saitokiku/whirlydawg/4_DRAWINGS/README.md

# Step 4 – drawings and pictures

| File | What it shows |
|---|---|
| `fabrication_drawings.pdf` | **main drawing set** (12 sheets): sizes of every part, cut-away view, which parts spin and which are fixed, assembly order, calculations |
| `assembly_exploded.pdf` | pulled-apart view and the order the parts go together |
| `assembly_section.pdf` | cut-in-half view showing how the blades lock into the caps |
| `rotor_vs_stationary.pdf` | orange = spins, blue = fixed to the roof |
| `CAD_views_top_side_underside.pdf` | top, side and bottom views |
| `comparison_16_20_24_blades.pdf` | why 20 blades: 16 leaves gaps, 24 chokes the airflow |
| `images/` | all pictures (PNG) |

All pictures and drawings are generated from the real 3D model, not drawn by hand.
