saitokiku/whirlydawg/2_BLADES_cut_and_bend/blade_and_roof_templates_1to1.pdf

## BLADE CUTTING TEMPLATE - 1:1 - PRINT AT 100 % / ACTUAL SIZE (NO FIT-TO-PAGE)

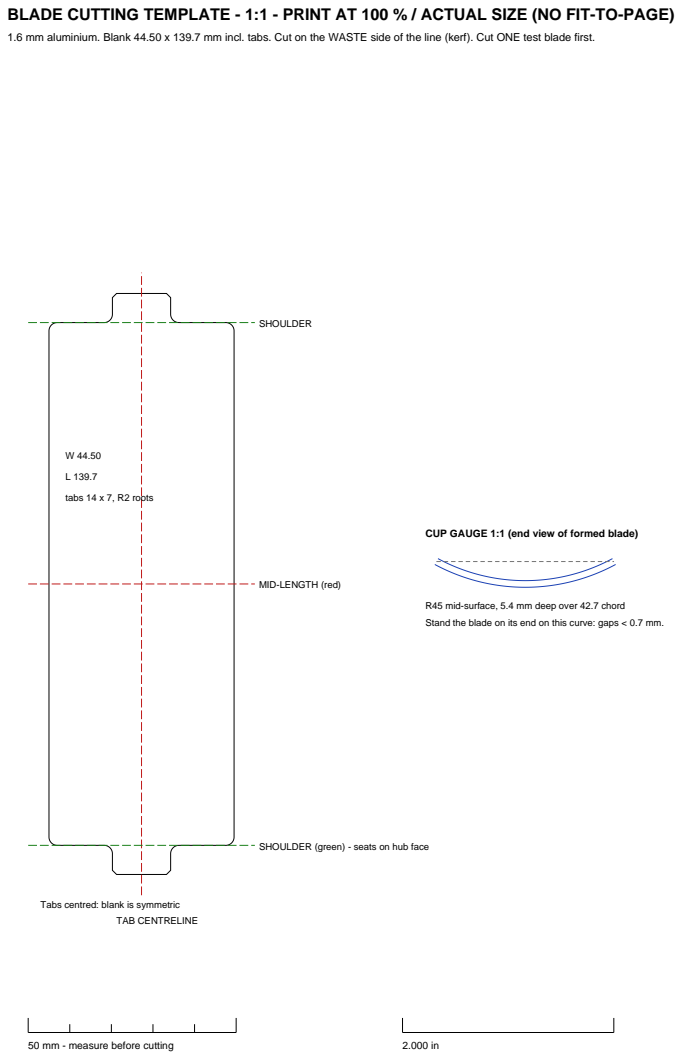
[picture p2: page 1]
SHOULDER; TAB CENTRELINE; tabs 14 x 7, R2 roots; 50 mm - measure before cutting

1.6 mm aluminium. Blank 44.50 x 139.7 mm incl. tabs. Cut on the WASTE side of the line (kerf). Cut ONE test blade first.

CUP GAUGE 1:1 (end view of formed blade)

MID-LENGTH (red)

R45 mid-surface, 5.4 mm deep over 42.7 chord
Stand the blade on its end on this curve: gaps < 0.7 mm.

SHOULDER (green) - seats on hub face

Tabs centred: blank is symmetric

## NESTED STOCK LAYOUT - 20 BLADES FROM 5 PIECES OF 11.75 x 3.75 in STOCK (SCALE 1:3)

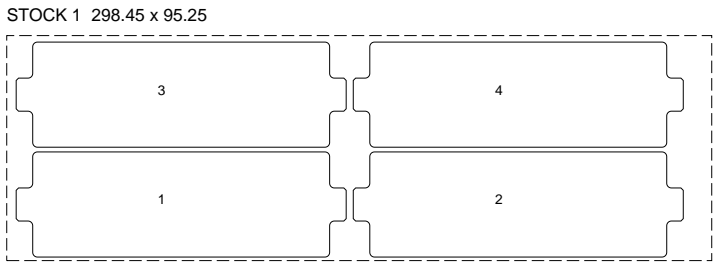
[picture p3: figure]
STOCK 1 298.45 x 95.25
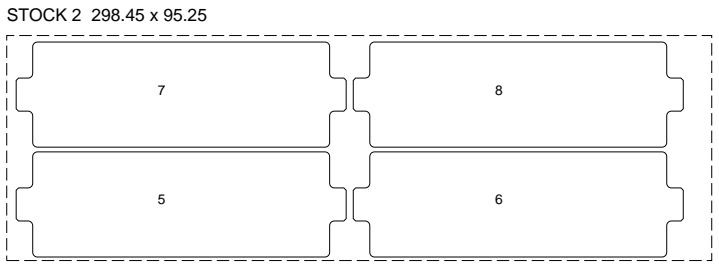
[picture p4: figure]
STOCK 2 298.45 x 95.25
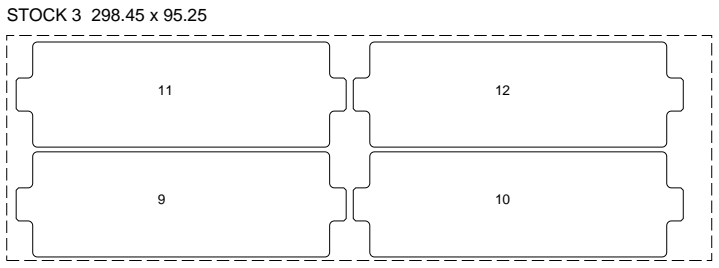
[picture p5: figure]
STOCK 3 298.45 x 95.25
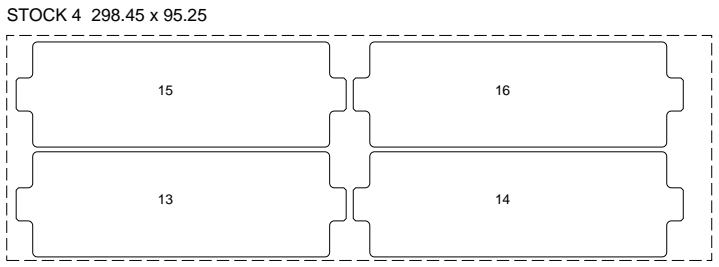
[picture p6: figure]
STOCK 4 298.45 x 95.25
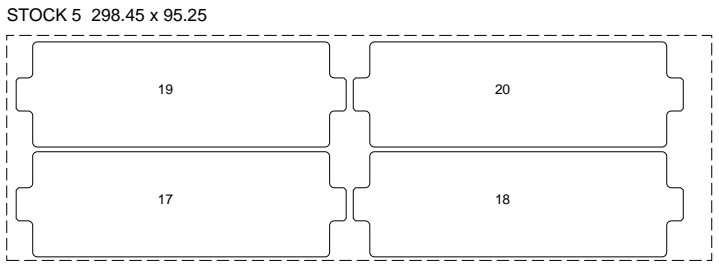
[picture p7: figure]
STOCK 5 298.45 x 95.25

Per stock piece: (1) rip 2 strips 44.5 wide (1.5 mm edge, 2 mm kerf between: 92.5 of 95.25 used);
(2) crosscut each strip at 4 + 139.7 = 143.7 mm and again at 286.4 mm (3 mm kerf);
(3) notch tabs, file R2 roots. Cut ONE blank first and check it against page 1 before cutting the rest.
The DXF blade_flat_pattern_all_blades.dxf carries the same nest at 1:1 for a CNC router, laser or paper template.

## ROOF CUT-OUT + SCREW TEMPLATE - QUADRANT 1:1 (rotate 4x about the centre mark)

CUT 127 mm (5 in hole saw)

FLANGE OUTLINE 230

SCREW CIRCLE 200

CENTRE (rotor axis) - align X line with roof slope (uphill = +X)

50 mm - measure before cutting | 2.000 in
