saitokiku/whirlydawg/4_DRAWINGS/CAD_views_top_side_underside.pdf

## TRUE CAD-RENDERED VIEWS: TOP / SIDE / UNDERSIDE

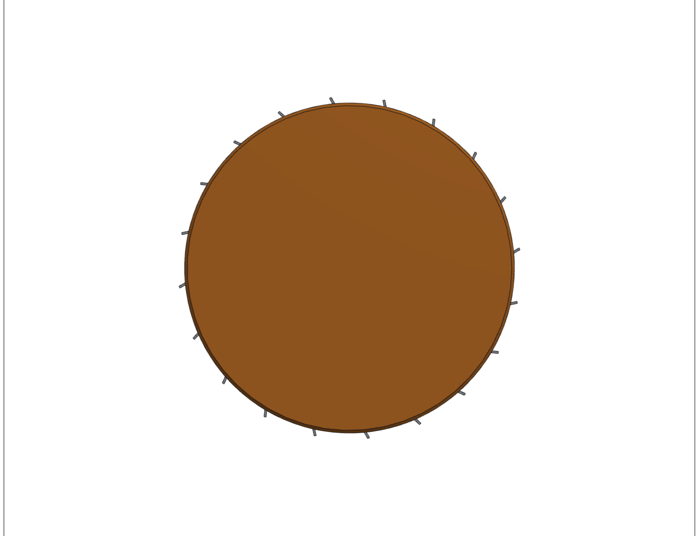
[picture p8: figure]
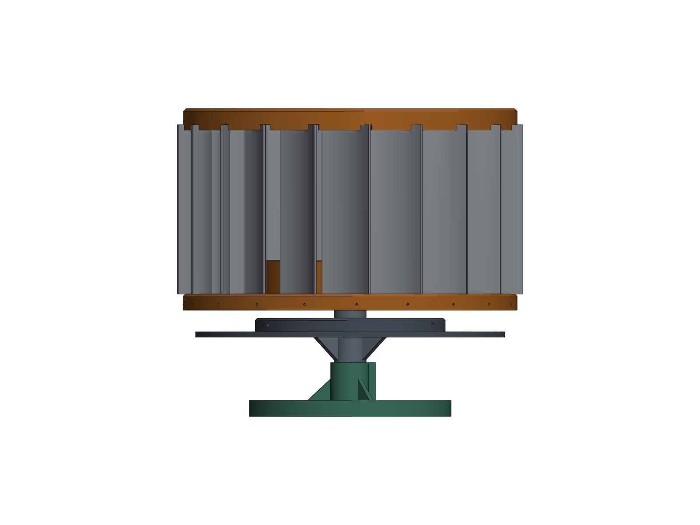
[picture p9: figure]
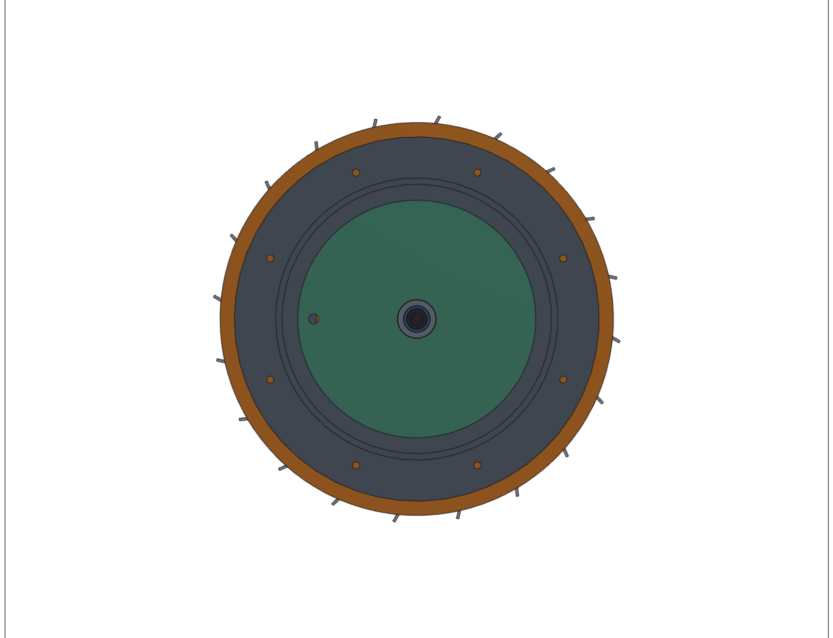
[picture p10: figure]

TOP | SIDE | UNDERSIDE

Orthographic renders of the tessellated build123d solids (no artistic imagery).
Orange = printed rotating hubs; silver = aluminium blades; grey-blue = stationary roof parts; green = optional drip tray.

DOGHOUSE WHIRLYBIRD - 20 CUPPED-BLADE ROTOR TRUE CAD-RENDERED VIEWS: TOP / SIDE / UNDERSIDE

REV DW-V2.0 UNITS mm SCALE NTS 2026-10-24
SHEET 1/1 Source: build123d parametric model + MASTER_PARAMETERS.json
