saitokiku/whirlydawg/whirlybird/reports/variant_study.csv

blades | chord_angle_deg | cup_radius_mm | tab_radius_mm | rotor_od_mm | air_channel_mm | plan_coverage_pct | cup_depth_mm | pocket_wall_mm | blade_set_mass_g | stock_pieces | installed_height_mm | meets_targets
16 | 45 | 40 | 109.2 | 257.9 | 20.9 | 71.8 | 6.0 | 6.71 | 400.0 | 4 | 169.7 | False
16 | 45 | 45 | 109.4 | 257.9 | 21.4 | 72.6 | 5.4 | 6.56 | 400.0 | 4 | 169.7 | False
16 | 45 | 60 | 109.8 | 257.9 | 22.4 | 73.9 | 4.1 | 6.18 | 400.0 | 4 | 169.7 | False
16 | 55 | 40 | 110.9 | 257.9 | 17.9 | 79.5 | 6.0 | 5.83 | 400.0 | 4 | 169.7 | False
16 | 55 | 45 | 111.2 | 257.9 | 18.2 | 80.3 | 5.4 | 5.6 | 400.0 | 4 | 169.7 | False
16 | 55 | 60 | 111.8 | 257.9 | 19.0 | 81.6 | 4.1 | 5.07 | 400.0 | 4 | 169.7 | False
16 | 65 | 40 | 113.1 | 257.9 | 14.6 | 84.7 | 6.0 | 4.66 | 400.0 | 4 | 169.7 | False
16 | 65 | 45 | 113.5 | 257.9 | 14.7 | 85.5 | 5.4 | 4.36 | 400.0 | 4 | 169.7 | False
16 | 65 | 60 | 114.3 | 257.9 | 15.1 | 86.8 | 4.1 | 3.69 | 400.0 | 4 | 169.7 | False
20 | 45 | 40 | 109.2 | 257.9 | 14.1 | 89.7 | 6.0 | 6.71 | 500.0 | 5 | 169.7 | False
20 | 45 | 45 | 109.4 | 257.9 | 14.6 | 90.8 | 5.4 | 6.56 | 500.0 | 5 | 169.7 | False
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
