saitokiku/whirlydawg/4_DRAWINGS/images/bearing_support_stationary.png

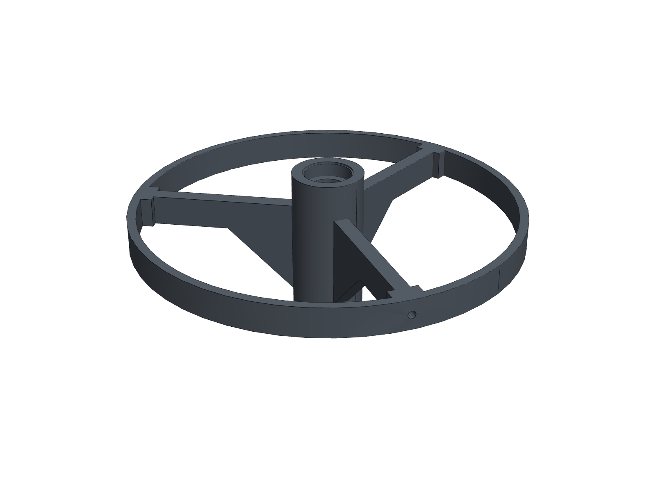
4_DRAWINGS/images/bearing_support_stationary.png
