saitokiku/whirlydawg/4_DRAWINGS/images/blade_formed.png

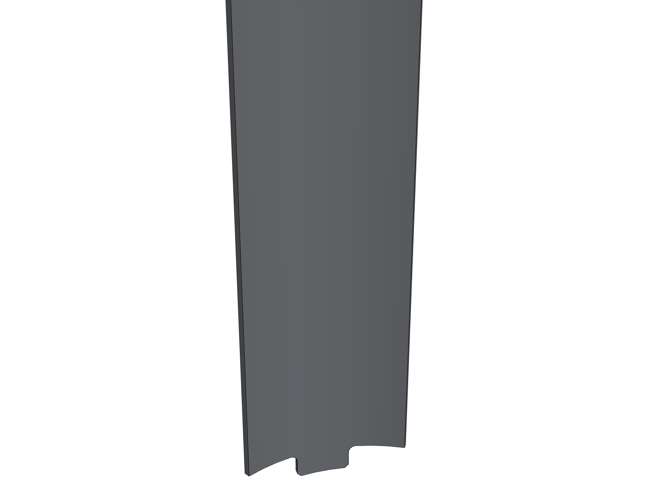
4_DRAWINGS/images/blade_formed.png
