saitokiku/whirlydawg/4_DRAWINGS/images/compare_16_blades_iso.png

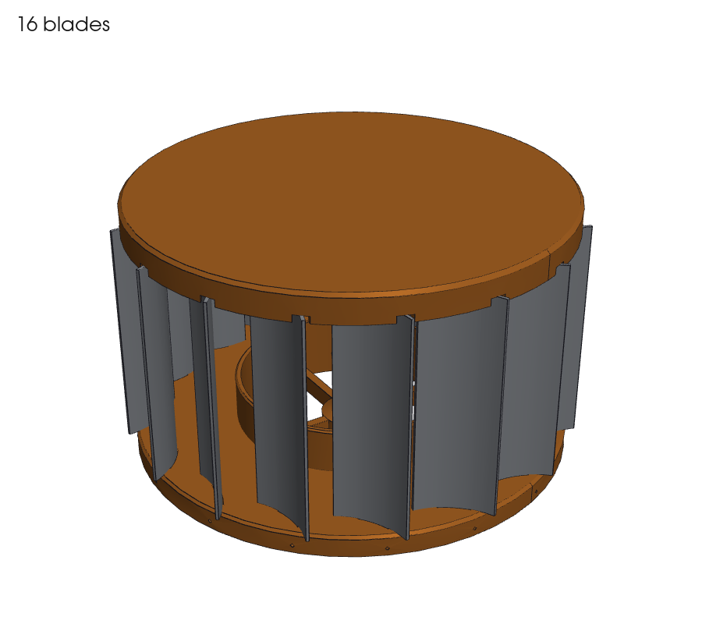
4_DRAWINGS/images/compare_16_blades_iso.png
