saitokiku/whirlydawg/4_DRAWINGS/images/compare_20_blades_iso.png

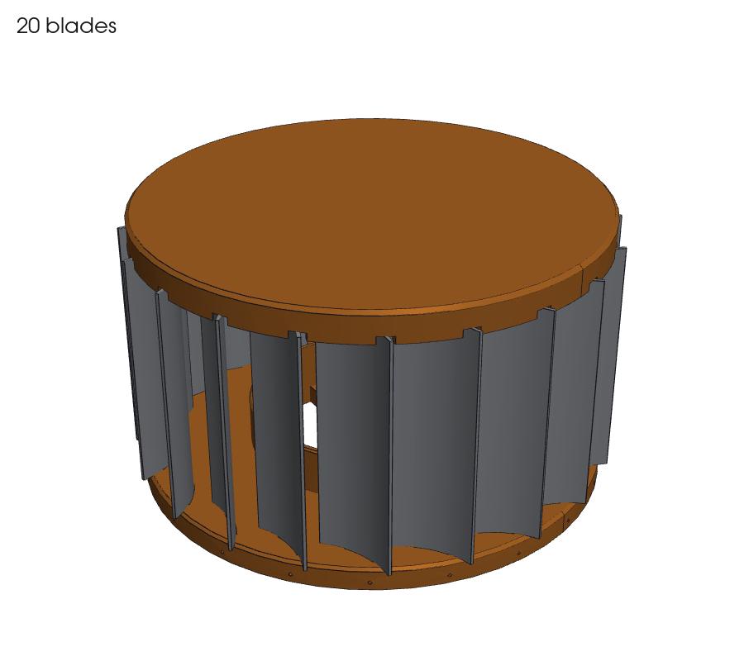
4_DRAWINGS/images/compare_20_blades_iso.png
