saitokiku/whirlydawg/4_DRAWINGS/images/forming_die_open.png

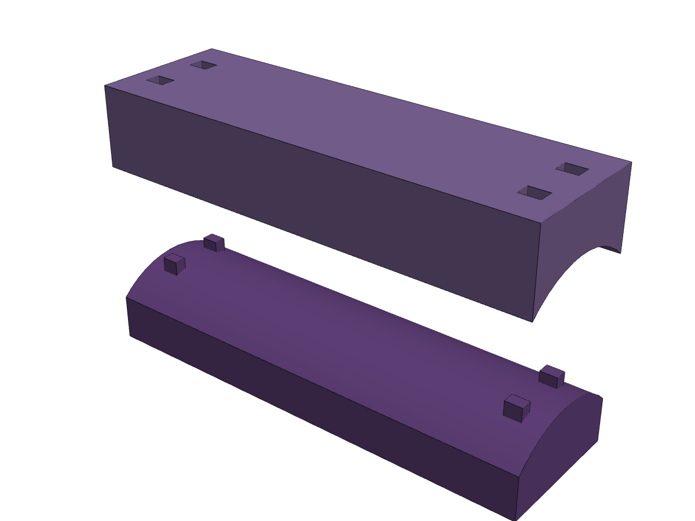
4_DRAWINGS/images/forming_die_open.png
