saitokiku/whirlydawg/4_DRAWINGS/images/lower_hub_bottom_closed.png

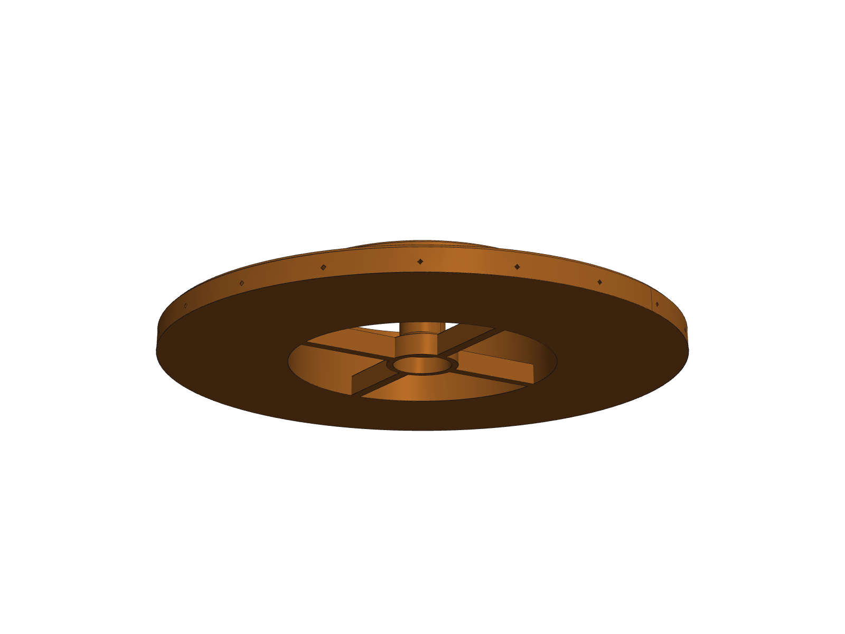
4_DRAWINGS/images/lower_hub_bottom_closed.png
