saitokiku/whirlydawg/4_DRAWINGS/images/lower_hub_top_blind_pockets.png

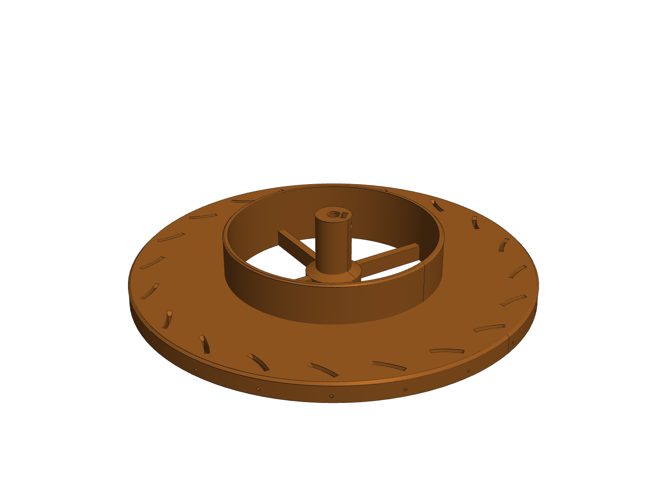
4_DRAWINGS/images/lower_hub_top_blind_pockets.png
