saitokiku/whirlydawg/4_DRAWINGS/images/lower_hub_top_plan.png

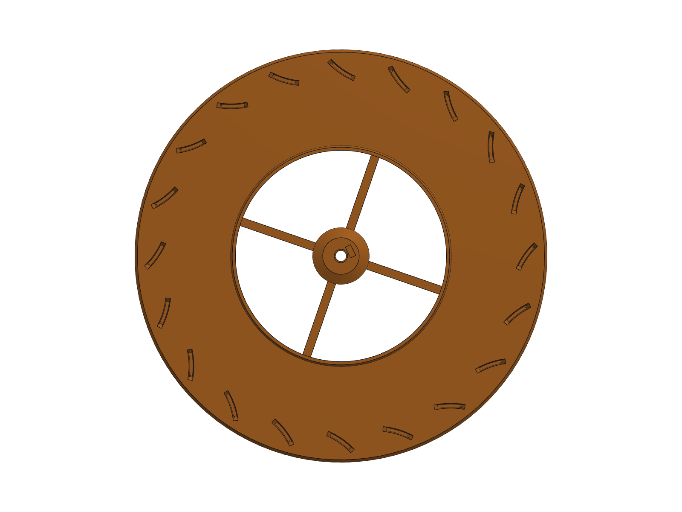
4_DRAWINGS/images/lower_hub_top_plan.png
