saitokiku/whirlydawg/4_DRAWINGS/images/pocket_section_lower.png

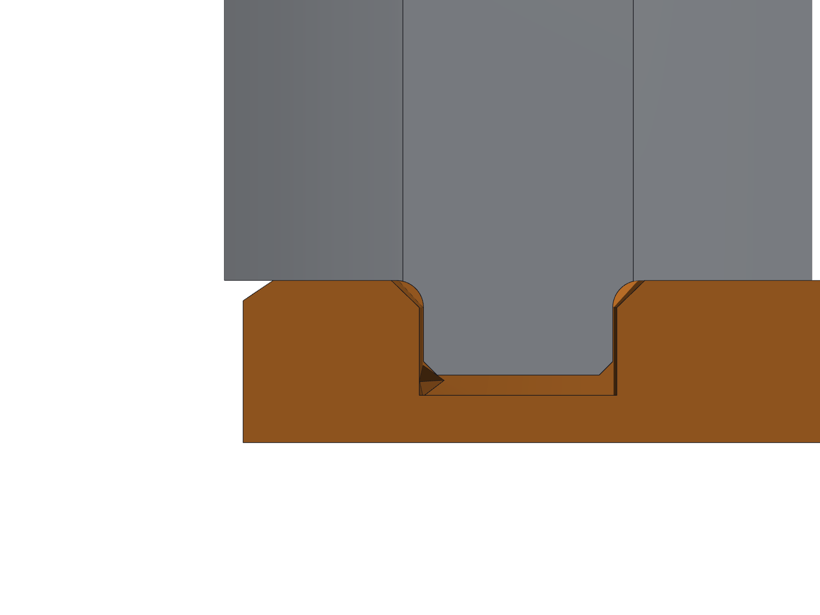
4_DRAWINGS/images/pocket_section_lower.png
