saitokiku/whirlydawg/4_DRAWINGS/images/pocket_section_upper.png

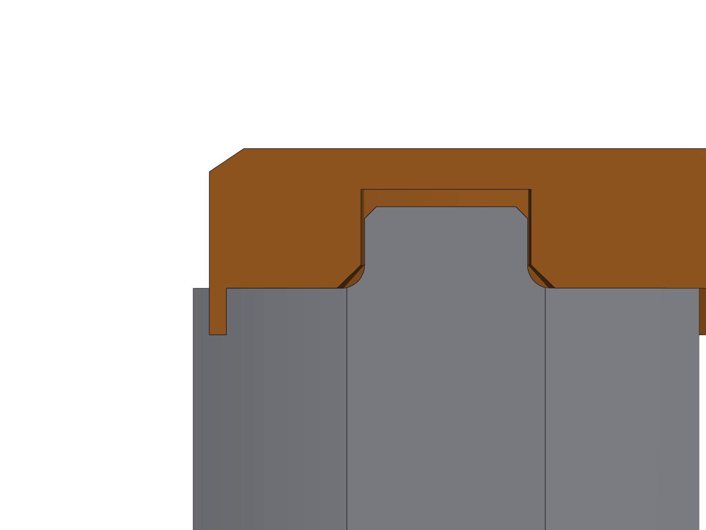
4_DRAWINGS/images/pocket_section_upper.png
