saitokiku/whirlydawg/4_DRAWINGS/images/rain_baffle_if_needed.png

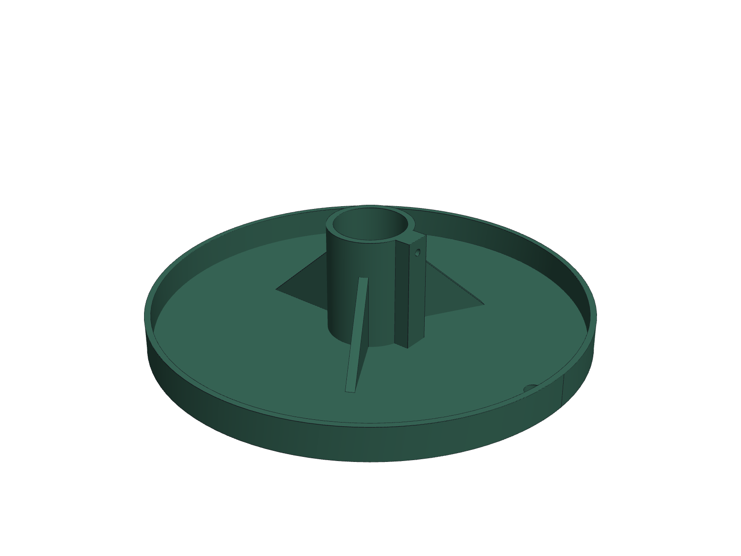
4_DRAWINGS/images/rain_baffle_if_needed.png
