saitokiku/whirlydawg/4_DRAWINGS/images/roof_flash_adapter.png

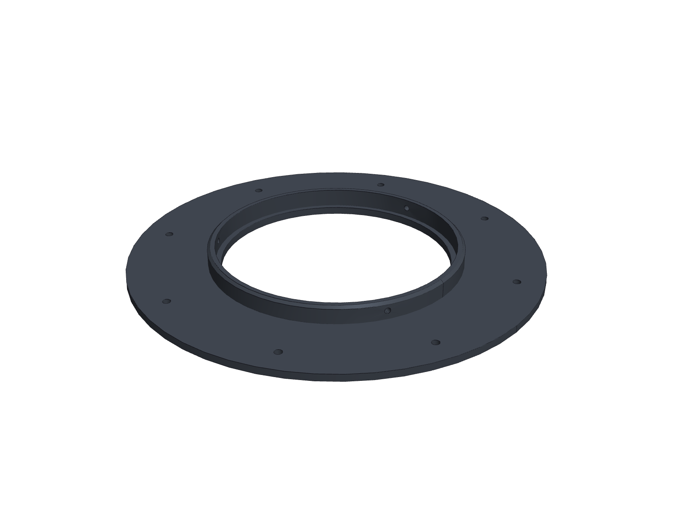
4_DRAWINGS/images/roof_flash_adapter.png
