saitokiku/whirlydawg/4_DRAWINGS/images/rotor_lifted_off_stationary.png

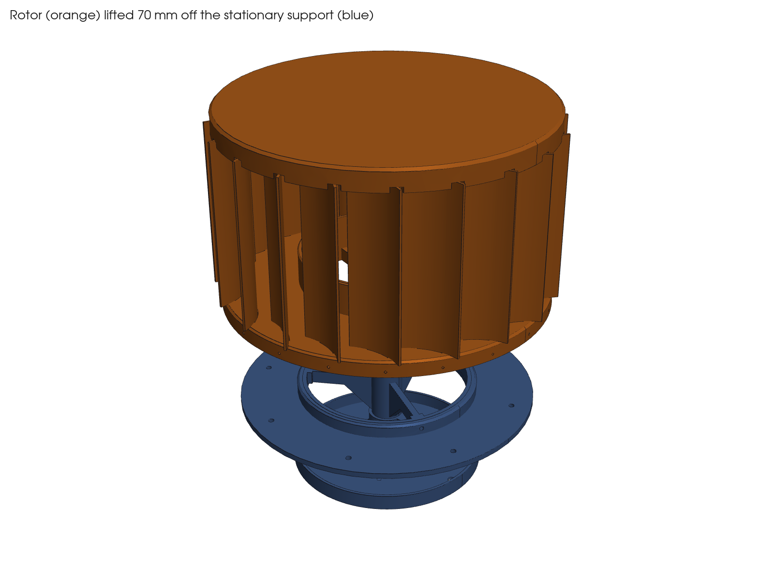
4_DRAWINGS/images/rotor_lifted_off_stationary.png
