saitokiku/whirlydawg/4_DRAWINGS/images/section_axial.png

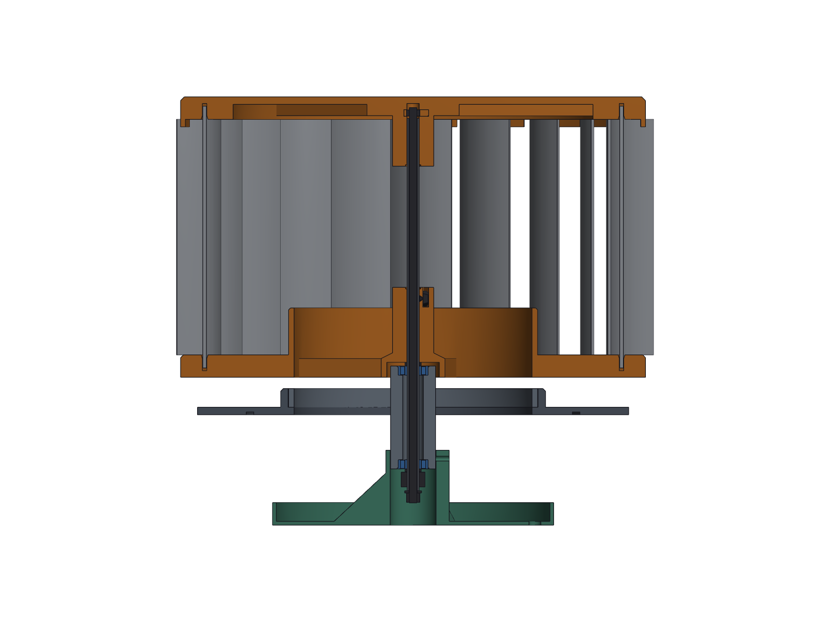
4_DRAWINGS/images/section_axial.png
