saitokiku/whirlydawg/4_DRAWINGS/images/section_axial_iso.png

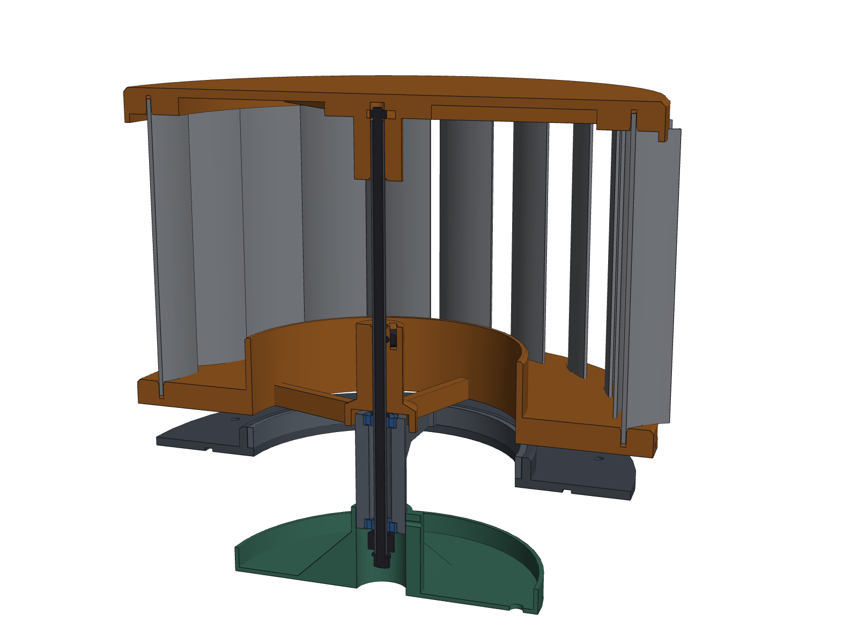
4_DRAWINGS/images/section_axial_iso.png
