saitokiku/whirlydawg/4_DRAWINGS/images/section_bearing_detail.png

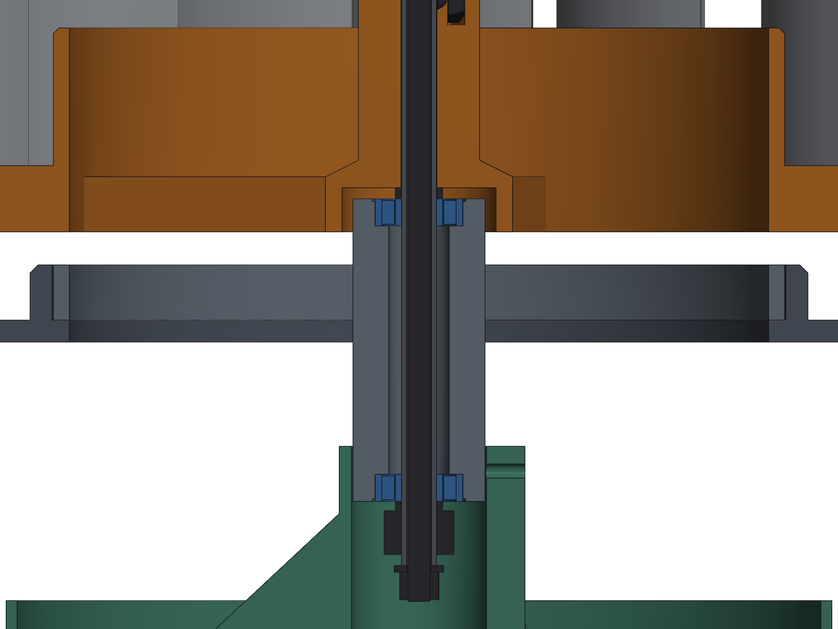
4_DRAWINGS/images/section_bearing_detail.png
