saitokiku/whirlydawg/4_DRAWINGS/images/upper_hub_top_closed.png

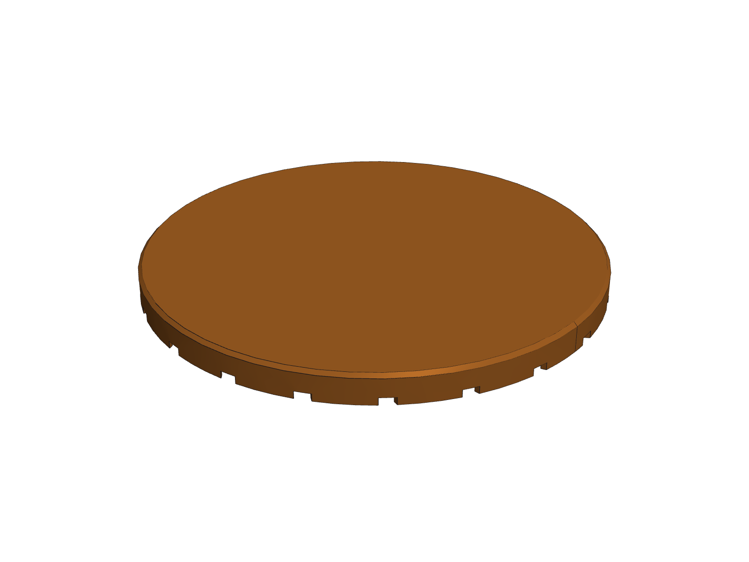
4_DRAWINGS/images/upper_hub_top_closed.png
