saitokiku/whirlydawg/4_DRAWINGS/images/upper_hub_underside_blind_pockets.png

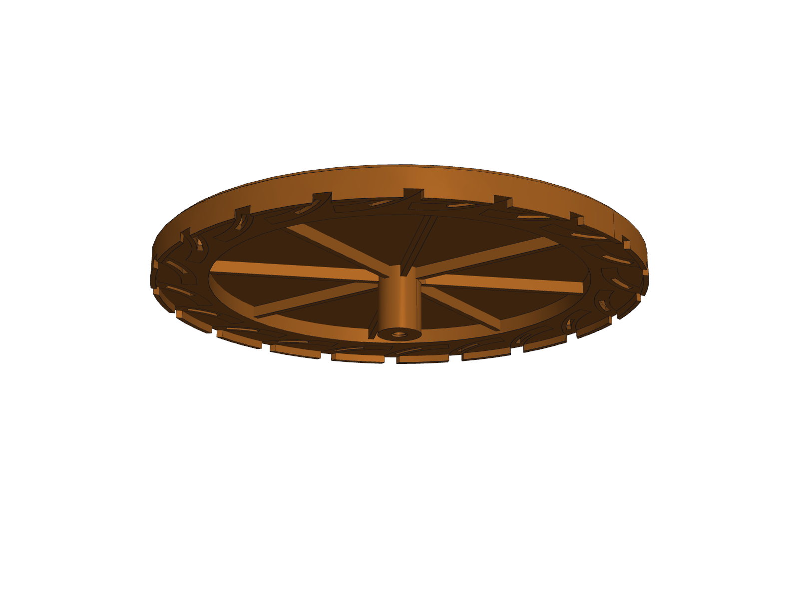
4_DRAWINGS/images/upper_hub_underside_blind_pockets.png
