saitokiku/whirlydawg/4_DRAWINGS/images/upper_hub_underside_plan.png

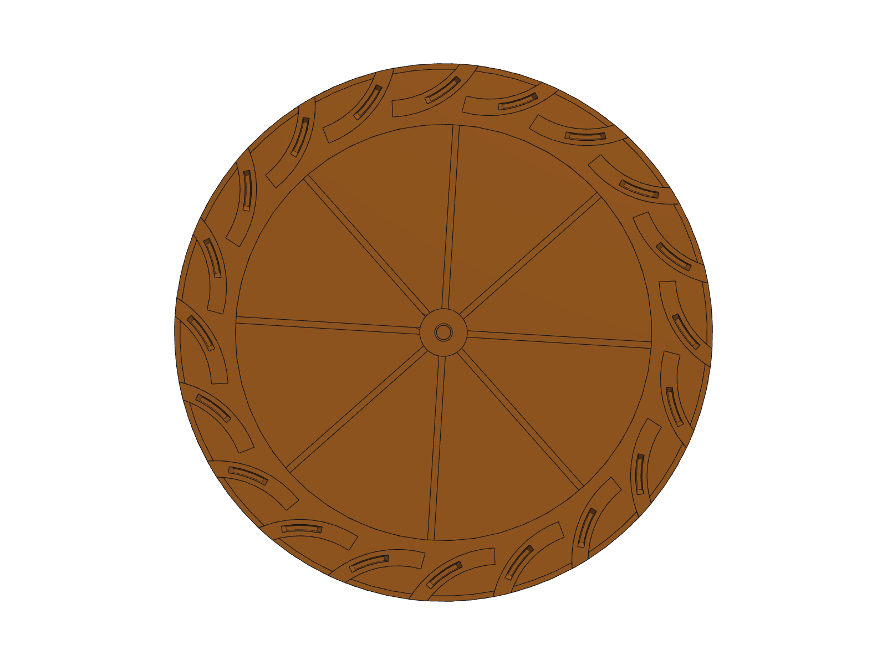
4_DRAWINGS/images/upper_hub_underside_plan.png
