saitokiku/whirlydawg/4_DRAWINGS/images/view_top.png

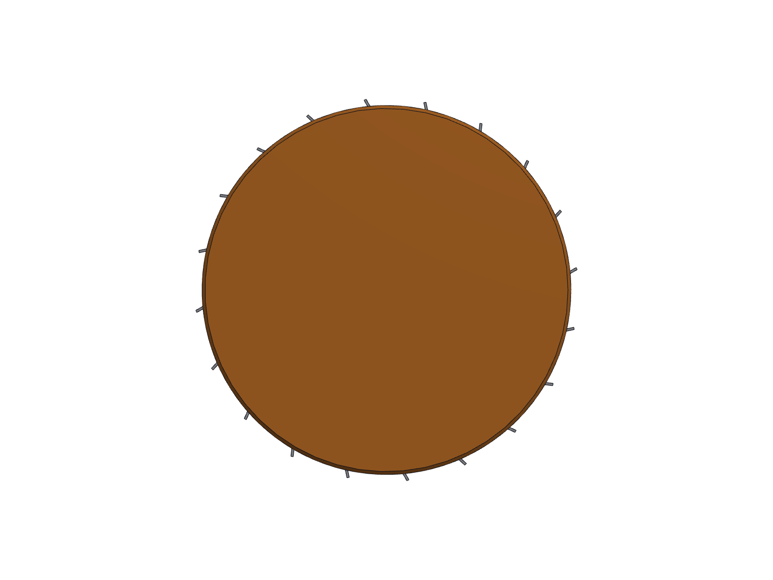
4_DRAWINGS/images/view_top.png
