saitokiku/whirlydawg/4_DRAWINGS/images/view_underside.png

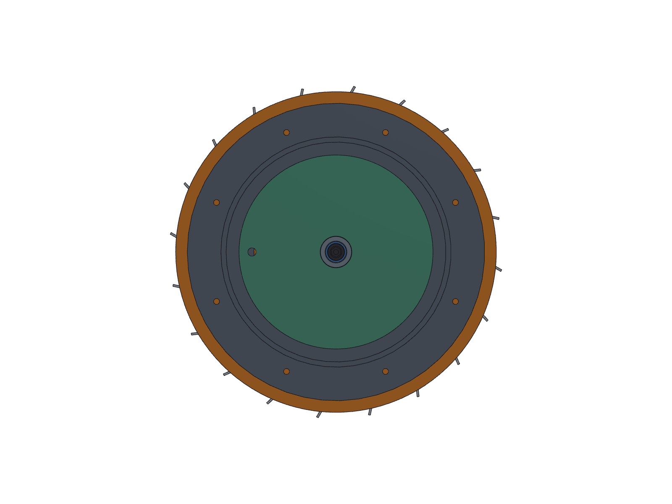
4_DRAWINGS/images/view_underside.png
