saitokiku/whirlydawg/5_3D_MODELS_STEP/whirlybird_complete_assembly.step

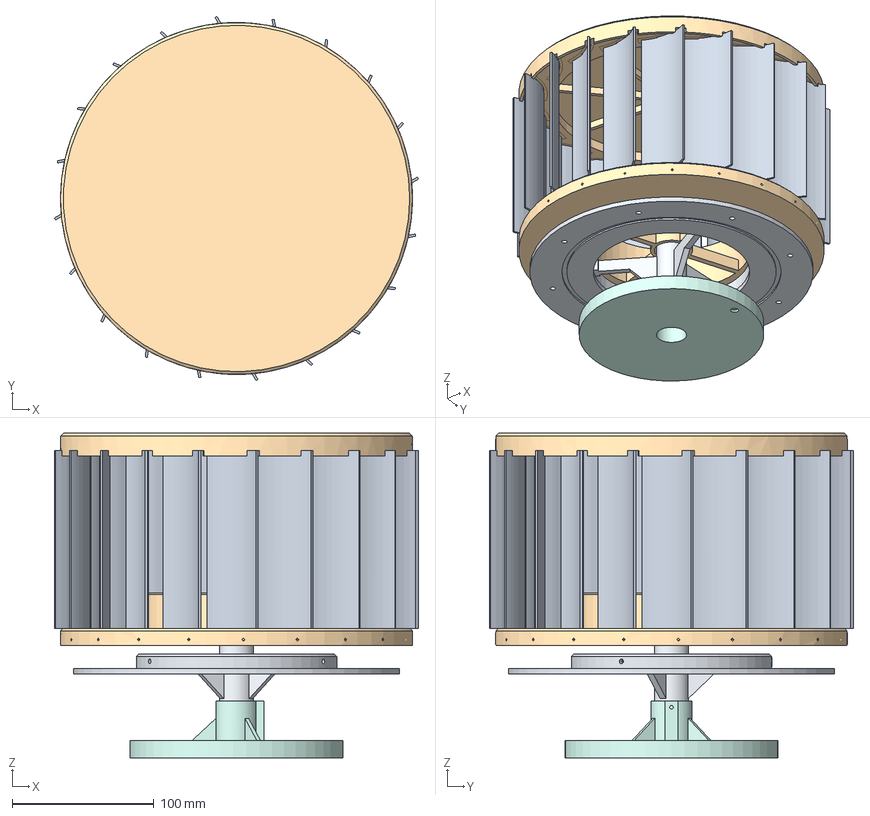
[picture p38: CAD file, 2026-10-24]
5_3D_MODELS_STEP/whirlybird_complete_assembly.step
256.4 x 256.4 x 228.6 mm
upper_hub_closed_top
lower_hub_closed_bottom
bearing_support_stationary
roof_flash_adapter
rain_baffle_if_needed
