saitokiku/whirlydawg/5_3D_MODELS_STEP/rotor_subassembly.step

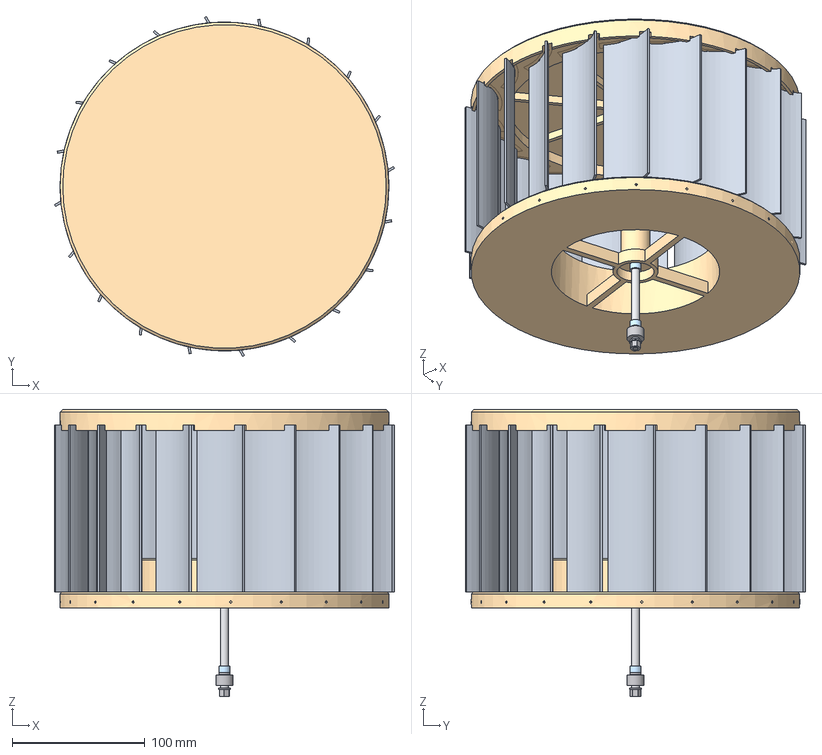
[picture p39: CAD file, 2026-10-24]
5_3D_MODELS_STEP/rotor_subassembly.step
256.4 x 256.4 x 216.8 mm
upper_hub_closed_top
lower_hub_closed_bottom
