saitokiku/whirlydawg/1_TEST_PRINTS_print_these_first/slot_clearance_coupon_1p85_1p95_2p05_2p15.stl

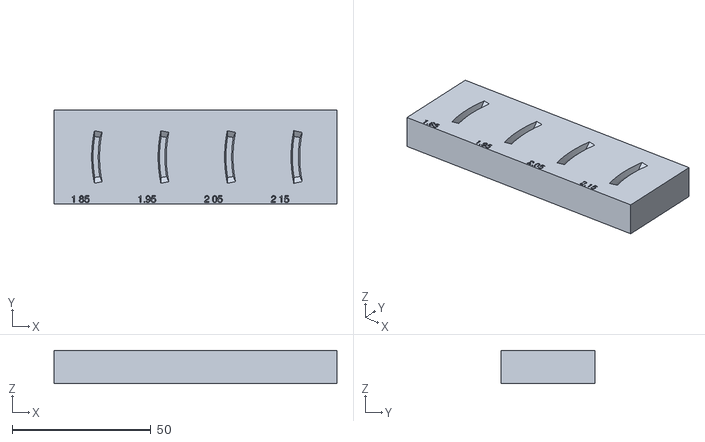
[picture p40: CAD file, 2026-10-24]
1_TEST_PRINTS_print_these_first/slot_clearance_coupon_1p85_1p95_2p05_2p15.stl
102.0 x 34.0 x 12.0
