saitokiku/whirlydawg/2_BLADES_cut_and_bend/blade_flat_pattern_single_TEST.dxf

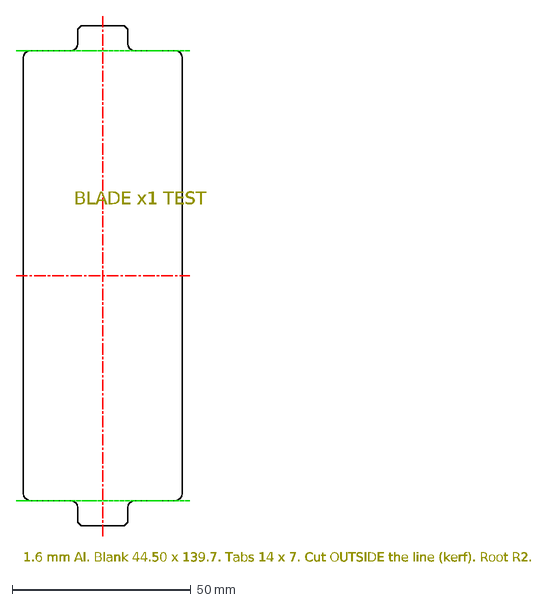
[picture p41: CAD file, 2026-10-24]
2_BLADES_cut_and_bend/blade_flat_pattern_single_TEST.dxf
BLADE x1 TEST
1.6 mm Al. Blank 44.50 x 139.7. Tabs 14 x 7. Cut OUTSIDE the line (kerf). Root R2.
