saitokiku/whirlydawg/3_PRINT_PARTS/lower_hub_closed_bottom.stl

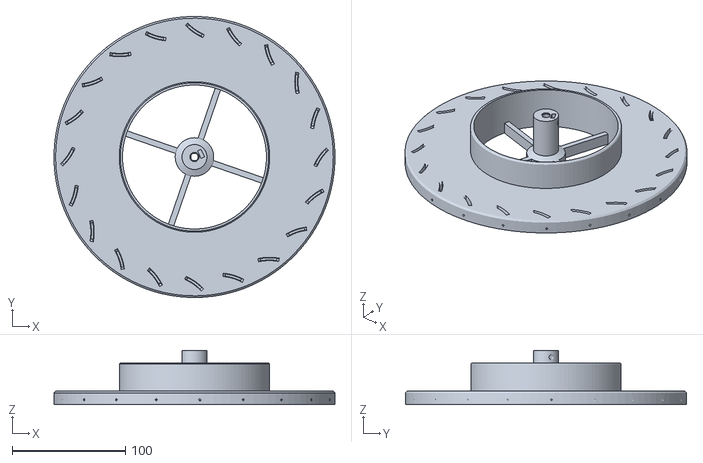
[picture p42: CAD file, 2026-10-24]
3_PRINT_PARTS/lower_hub_closed_bottom.stl
247.9 x 248.0 x 48.0
