saitokiku/whirlydawg/3_PRINT_PARTS/roof_adapter_pick_ONE_for_your_roof_pitch/roof_flash_adapter_pitch_5in12.stl

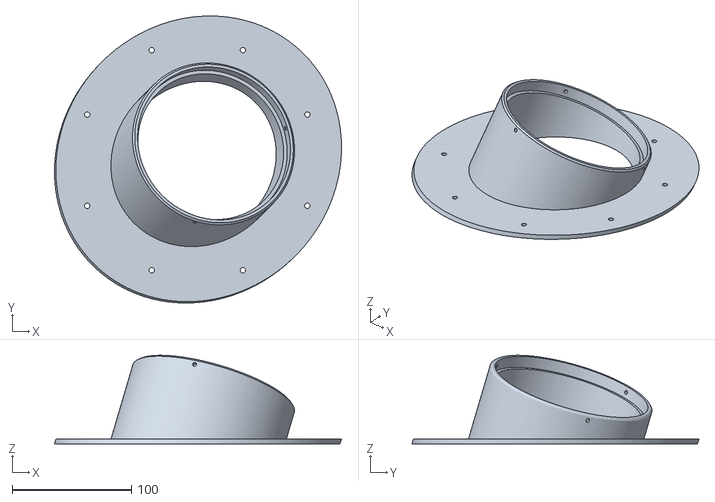
[picture p43: CAD file, 2026-10-24]
3_PRINT_PARTS/roof_adapter_pick_ONE_for_your_roof_pitch/roof_flash_adapter_pitch_5in12.stl
240.9 x 240.9 x 74.3
