saitokiku/whirlydawg/5_3D_MODELS_STEP/lower_hub_SOLID_DISC_ALTERNATE_not_recommended.step

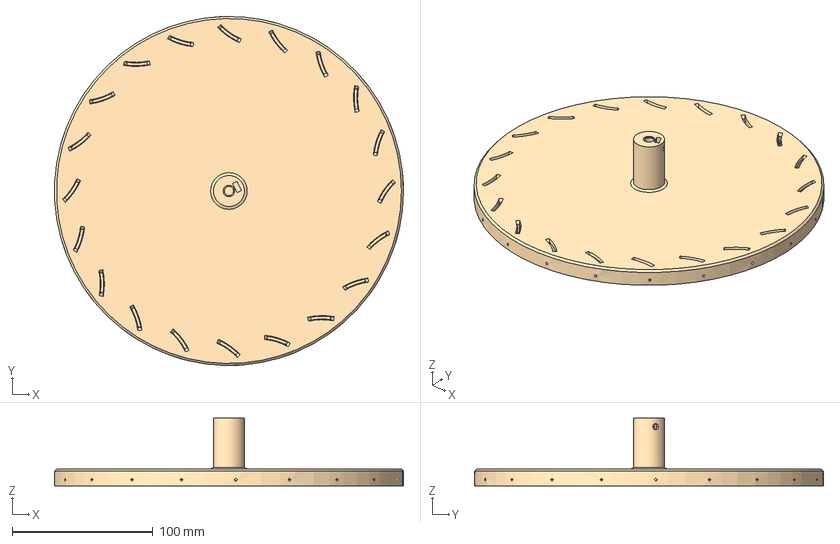
[picture p44: CAD file, 2026-10-24]
5_3D_MODELS_STEP/lower_hub_SOLID_DISC_ALTERNATE_not_recommended.step
247.9 x 247.9 x 48.0 mm
