saitokiku/whirlydawg/1_TEST_PRINTS_print_these_first/single_blade_socket_test_top.stl

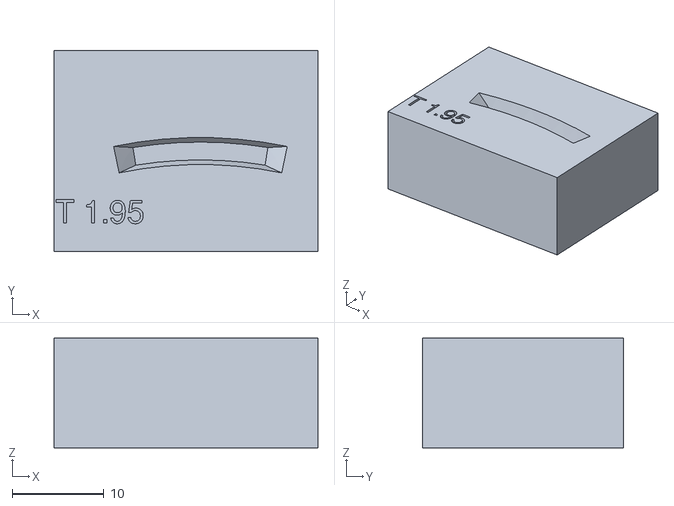
[picture p45: CAD file, 2026-10-24]
1_TEST_PRINTS_print_these_first/single_blade_socket_test_top.stl
28.8 x 22.0 x 12.0
