saitokiku/whirlydawg/2_BLADES_cut_and_bend/blade_forming_die_lower.stl

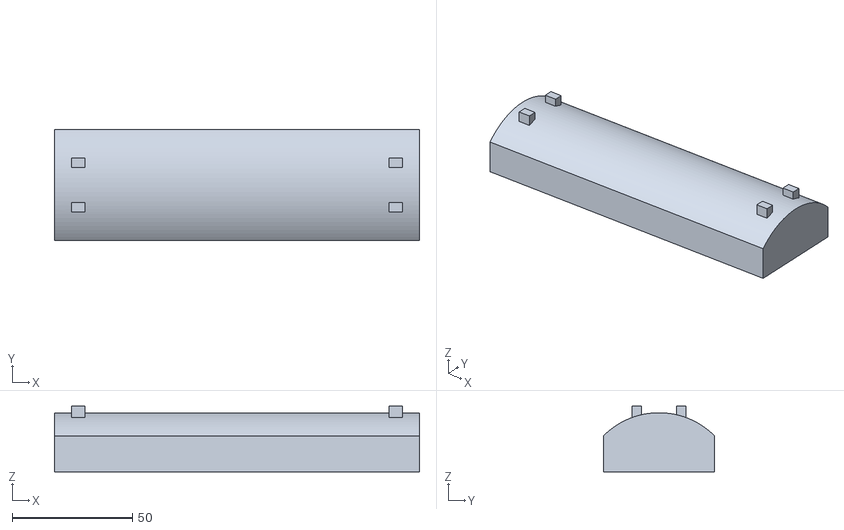
[picture p46: CAD file, 2026-10-24]
2_BLADES_cut_and_bend/blade_forming_die_lower.stl
151.7 x 46.1 x 27.3
