saitokiku/whirlydawg/3_PRINT_PARTS/optional/rain_baffle_if_needed.stl

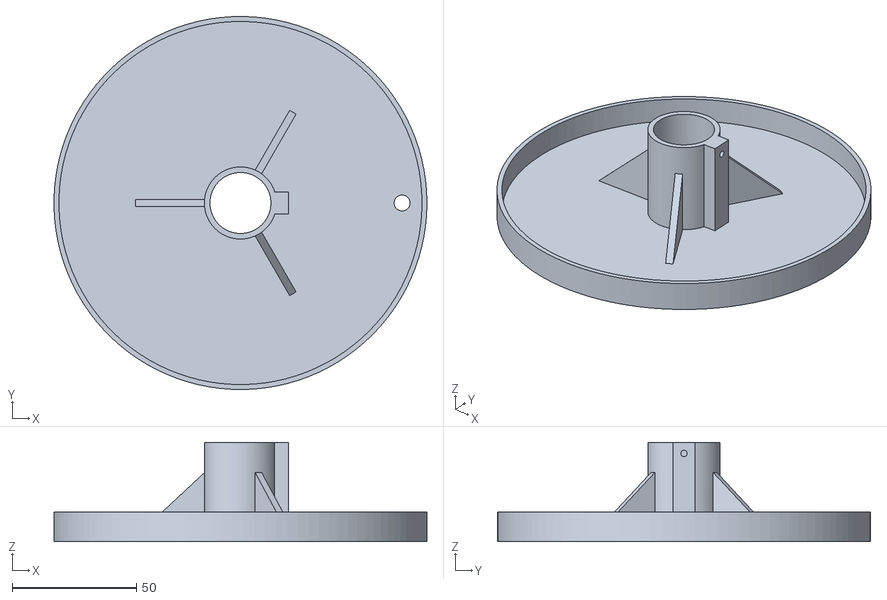
[picture p47: CAD file, 2026-10-23]
3_PRINT_PARTS/optional/rain_baffle_if_needed.stl
150.0 x 150.0 x 40.0
