saitokiku/whirlydawg/3_PRINT_PARTS/roof_adapter_pick_ONE_for_your_roof_pitch/roof_flash_adapter_pitch_3in12.stl

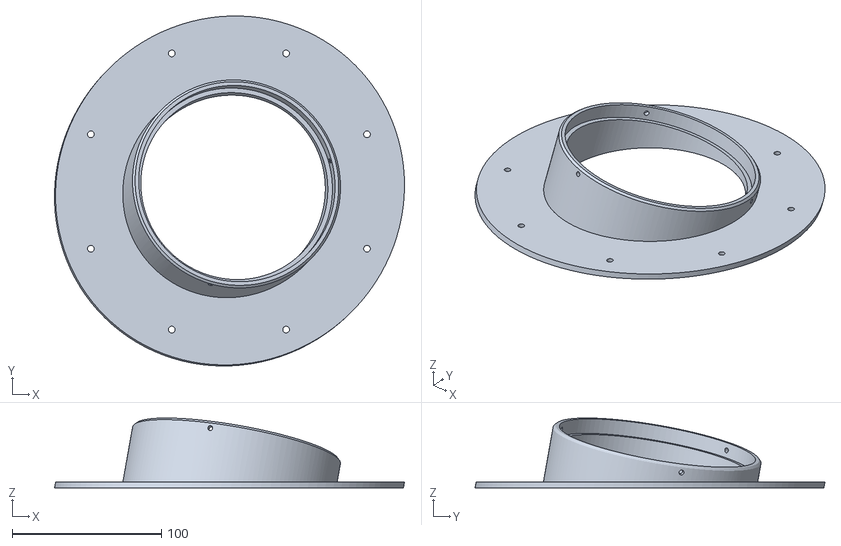
[picture p48: CAD file, 2026-10-24]
3_PRINT_PARTS/roof_adapter_pick_ONE_for_your_roof_pitch/roof_flash_adapter_pitch_3in12.stl
234.2 x 234.2 x 46.8
