saitokiku/whirlydawg/3_PRINT_PARTS/upper_hub_closed_top.stl

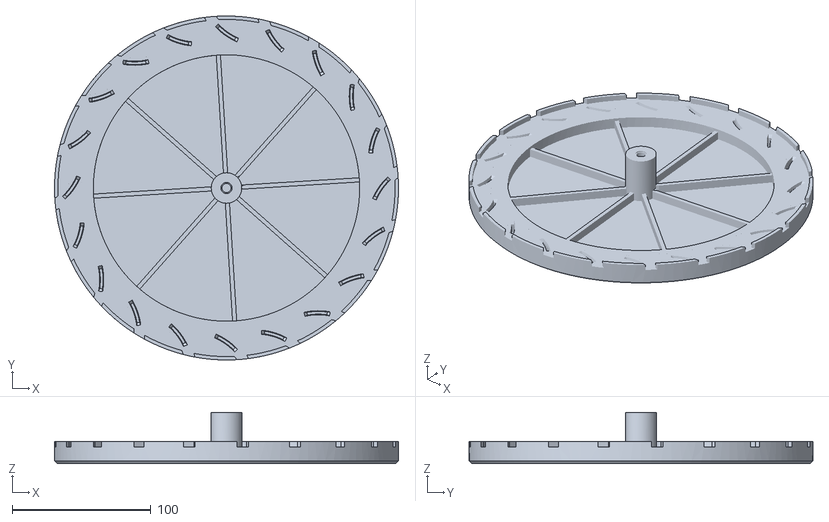
[picture p49: CAD file, 2026-10-24]
3_PRINT_PARTS/upper_hub_closed_top.stl
248.0 x 248.0 x 37.0
