saitokiku/whirlydawg/2_BLADES_cut_and_bend/blade_flat_pattern_all_blades.dxf

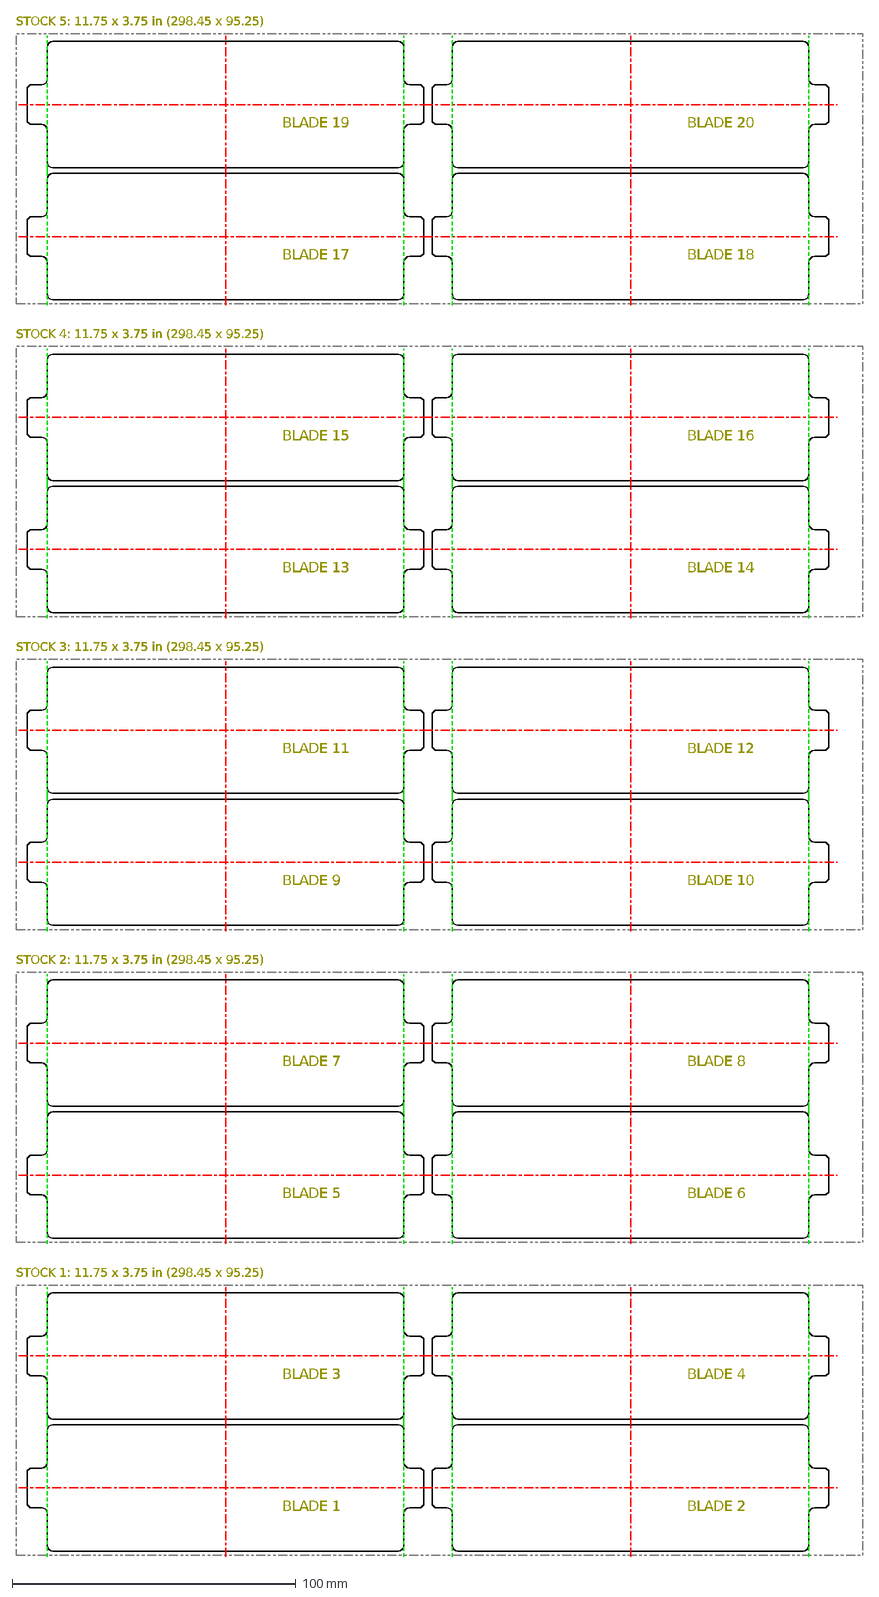
[picture p50: CAD file, 2026-10-24]
2_BLADES_cut_and_bend/blade_flat_pattern_all_blades.dxf
STOCK 1: 11.75 x 3.75 in (298.45 x 95.25)
BLADE 1
BLADE 2
BLADE 3
BLADE 4
STOCK 2: 11.75 x 3.75 in (298.45 x 95.25)
BLADE 5
BLADE 6
BLADE 7
BLADE 8
STOCK 3: 11.75 x 3.75 in (298.45 x 95.25)
BLADE 9
BLADE 10
BLADE 11
BLADE 12
STOCK 4: 11.75 x 3.75 in (298.45 x 95.25)
BLADE 13
BLADE 14
BLADE 15
BLADE 16
STOCK 5: 11.75 x 3.75 in (298.45 x 95.25)
BLADE 17
BLADE 18
BLADE 19
BLADE 20
