saitokiku/whirlydawg/3_PRINT_PARTS/roof_adapter_pick_ONE_for_your_roof_pitch/roof_flash_adapter_pitch_4in12.stl

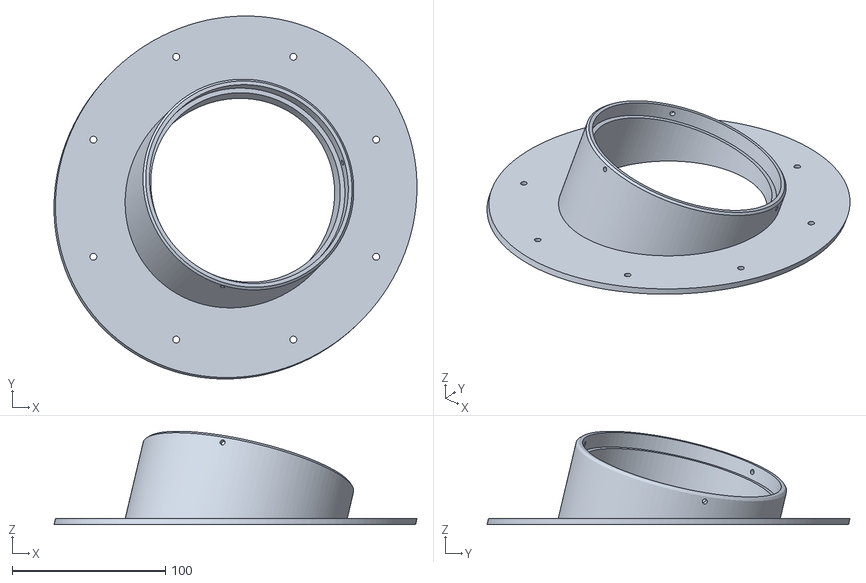
[picture p51: CAD file, 2026-10-24]
3_PRINT_PARTS/roof_adapter_pick_ONE_for_your_roof_pitch/roof_flash_adapter_pitch_4in12.stl
237.2 x 237.2 x 61.1
