saitokiku/whirlydawg/5_3D_MODELS_STEP/inlet_vent_louver.step

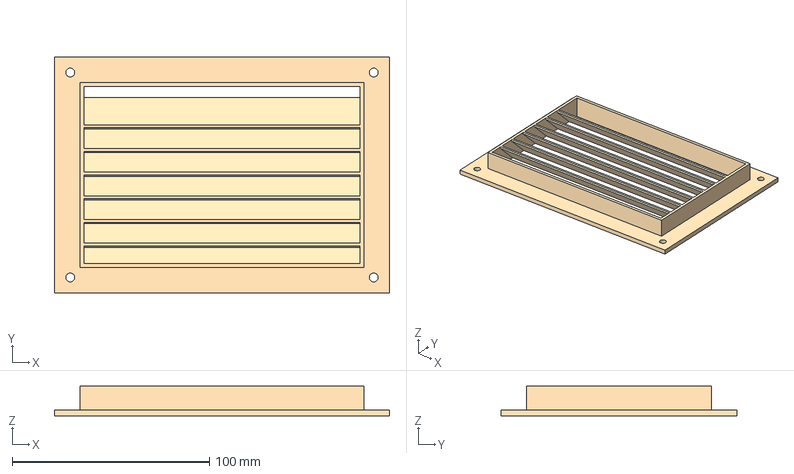
[picture p52: CAD file, 2026-10-24]
5_3D_MODELS_STEP/inlet_vent_louver.step
170.0 x 120.0 x 15.0 mm
