saitokiku/whirlydawg/1_TEST_PRINTS_print_these_first/bearing_and_shaft_fit_coupon.stl

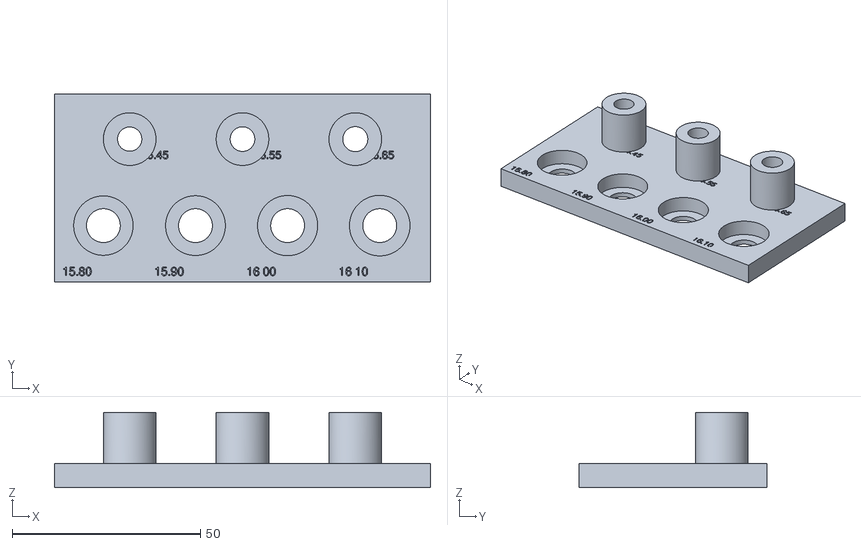
[picture p53: CAD file, 2026-10-23]
1_TEST_PRINTS_print_these_first/bearing_and_shaft_fit_coupon.stl
100.0 x 50.0 x 20.0
