saitokiku/whirlydawg/3_PRINT_PARTS/roof_adapter_pick_ONE_for_your_roof_pitch/roof_flash_adapter_pitch_0in12.stl

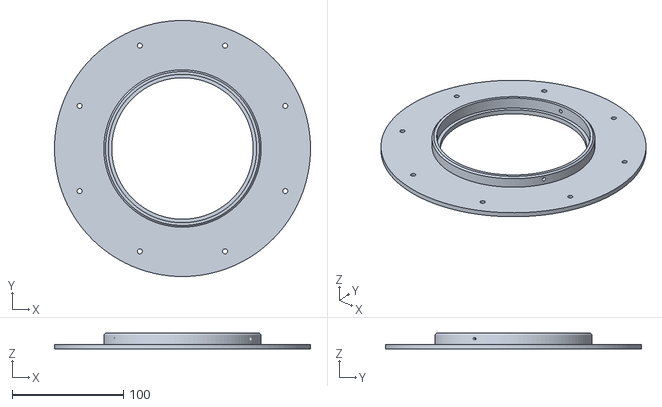
[picture p55: CAD file, 2026-10-23]
3_PRINT_PARTS/roof_adapter_pick_ONE_for_your_roof_pitch/roof_flash_adapter_pitch_0in12.stl
229.9 x 230.0 x 14.0
