saitokiku/whirlydawg/2_BLADES_cut_and_bend/blade_flat_pattern_8x.dxf

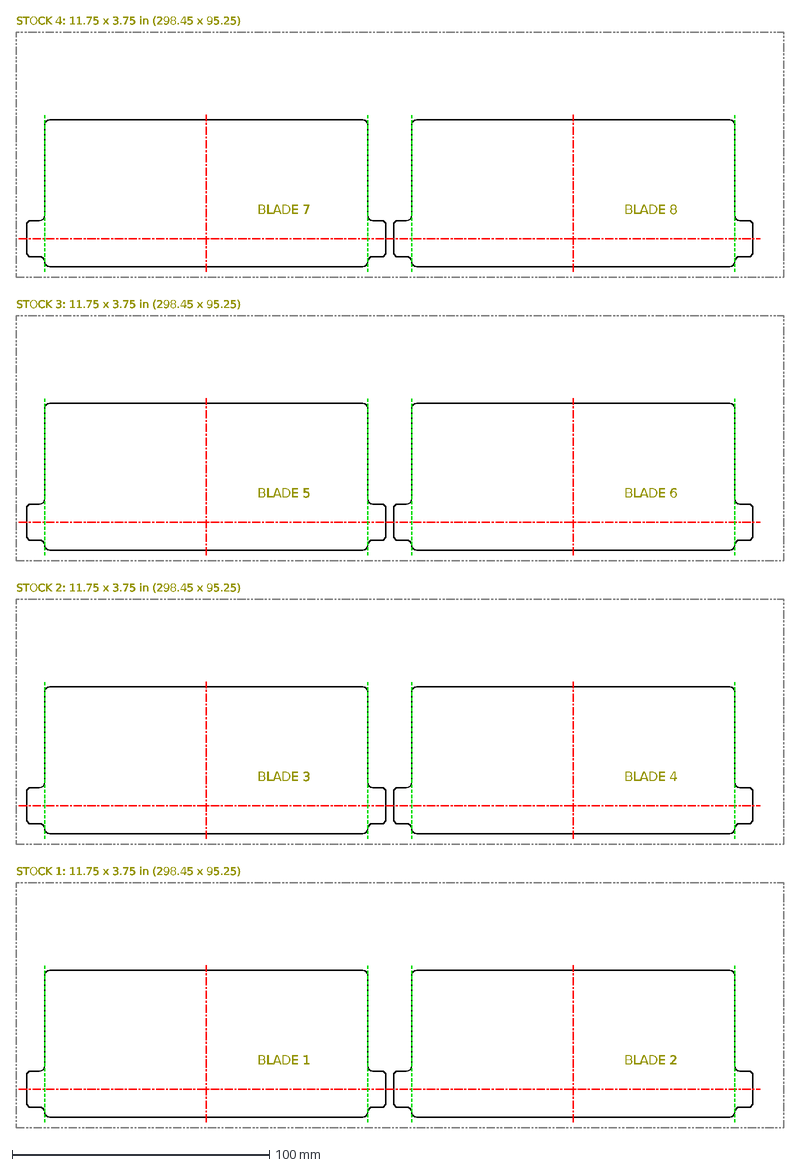
[picture p56: CAD file, 2026-10-23]
2_BLADES_cut_and_bend/blade_flat_pattern_8x.dxf
STOCK 1: 11.75 x 3.75 in (298.45 x 95.25)
BLADE 1
BLADE 2
STOCK 2: 11.75 x 3.75 in (298.45 x 95.25)
BLADE 3
BLADE 4
STOCK 3: 11.75 x 3.75 in (298.45 x 95.25)
BLADE 5
BLADE 6
STOCK 4: 11.75 x 3.75 in (298.45 x 95.25)
BLADE 7
BLADE 8
