saitokiku/whirlydawg/3_PRINT_PARTS/bearing_support_stationary.stl

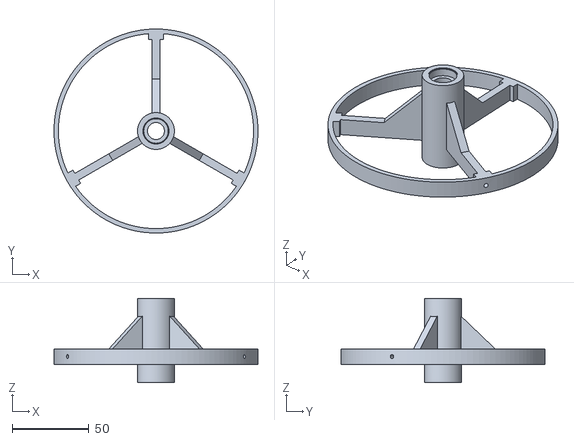
[picture p57: CAD file, 2026-10-23]
3_PRINT_PARTS/bearing_support_stationary.stl
132.8 x 132.8 x 54.9
