saitokiku/whirlydawg/3_PRINT_PARTS/roof_adapter_pick_ONE_for_your_roof_pitch/roof_flash_adapter_pitch_2in12.stl

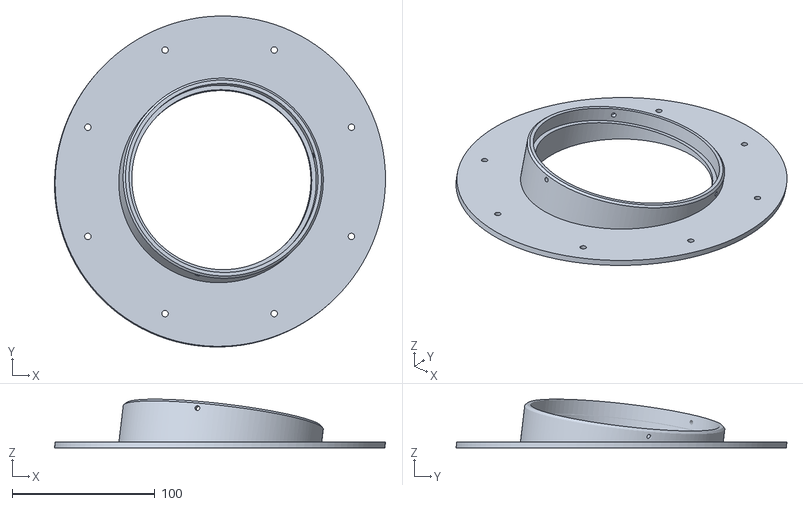
[picture p58: CAD file, 2026-10-23]
3_PRINT_PARTS/roof_adapter_pick_ONE_for_your_roof_pitch/roof_flash_adapter_pitch_2in12.stl
232.1 x 232.0 x 34.1
