saitokiku/whirlydawg/3_PRINT_PARTS/shaft_dimple_drill_guide.stl

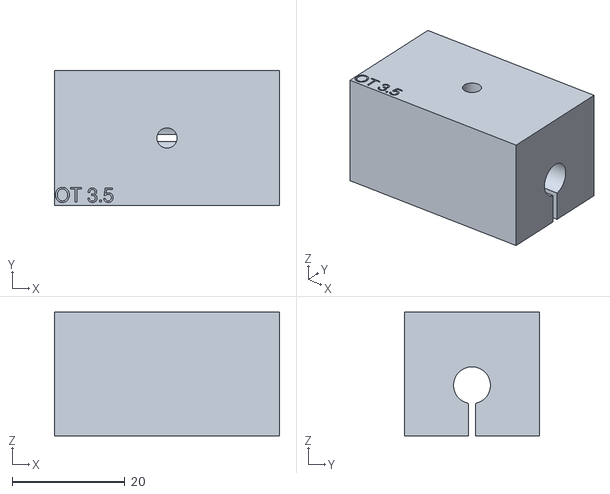
[picture p59: CAD file, 2026-10-23]
3_PRINT_PARTS/shaft_dimple_drill_guide.stl
40.0 x 24.0 x 22.0
