saitokiku/whirlydawg/5_3D_MODELS_STEP/roof_flash_adapter_pitch_2in12.step

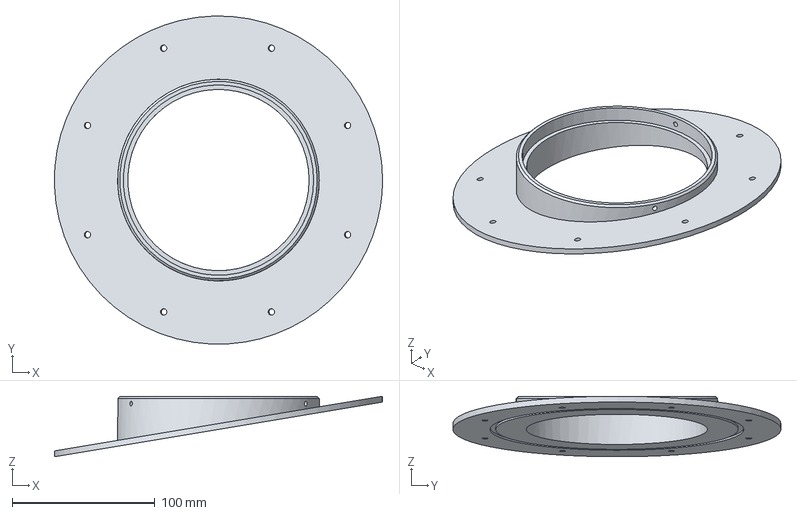
[picture p60: CAD file, 2026-10-24]
5_3D_MODELS_STEP/roof_flash_adapter_pitch_2in12.step
229.9 x 229.8 x 42.4 mm
