saitokiku/whirlydawg/5_3D_MODELS_STEP/roof_flash_adapter_pitch_4in12.step

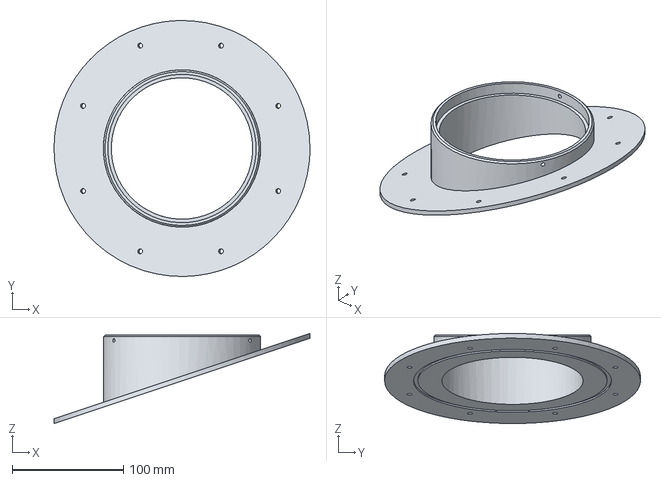
[picture p62: CAD file, 2026-10-24]
5_3D_MODELS_STEP/roof_flash_adapter_pitch_4in12.step
230.0 x 229.9 x 80.9 mm
