saitokiku/whirlydawg/5_3D_MODELS_STEP/shaft.step

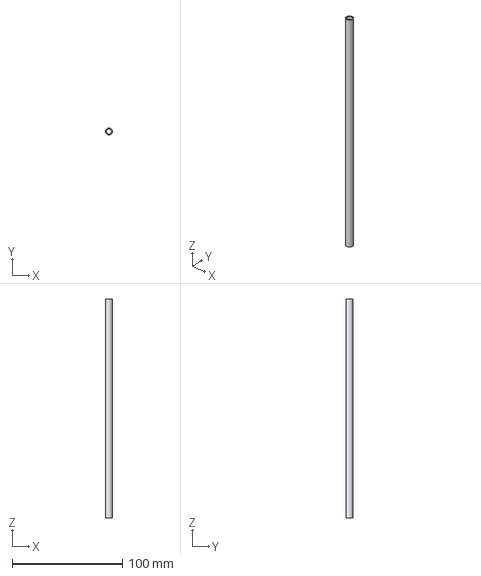
[picture p63: CAD file, 2026-10-24]
5_3D_MODELS_STEP/shaft.step
6.34 x 6.35 x 198.8 mm
