saitokiku/whirlydawg/5_3D_MODELS_STEP/roof_flash_adapter_pitch_5in12.step

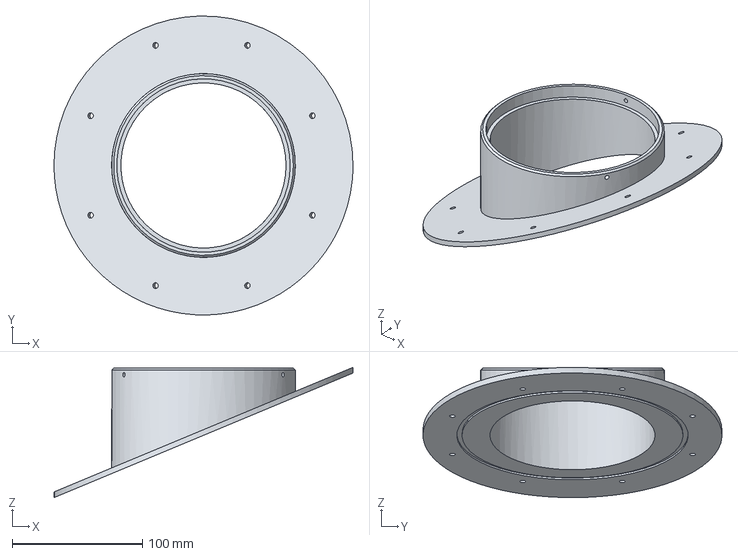
[picture p64: CAD file, 2026-10-24]
5_3D_MODELS_STEP/roof_flash_adapter_pitch_5in12.step
230.0 x 229.9 x 100.2 mm
