saitokiku/whirlydawg/5_3D_MODELS_STEP/blade_formed.step

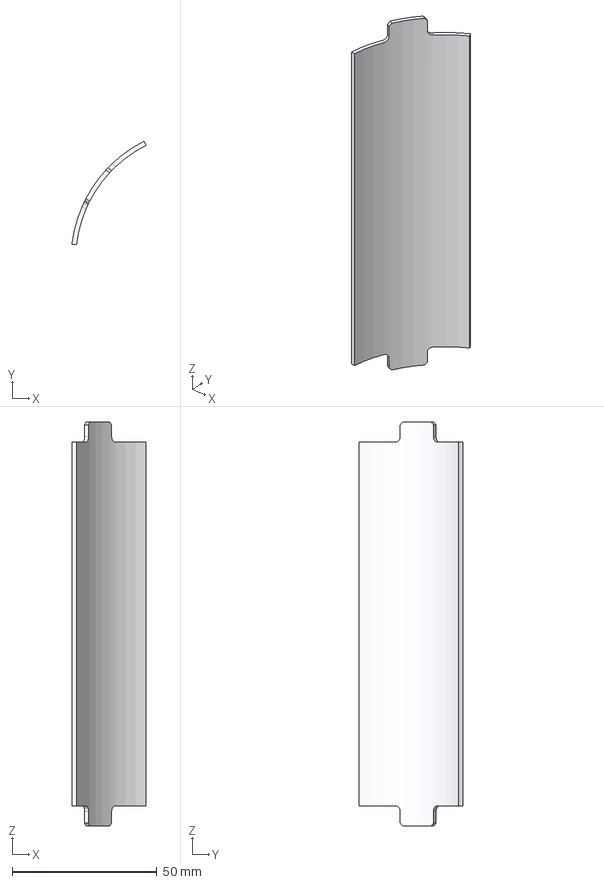
[picture p65: CAD file, 2026-10-24]
5_3D_MODELS_STEP/blade_formed.step
25.7 x 35.8 x 139.7 mm
