saitokiku/whirlydawg/(list of files, cad)

Other CAD files:
3_PRINT_PARTS/optional/lower_hub_SOLID_DISC_ALTERNATE_not_recommended.stl
5_3D_MODELS_STEP/single_blade_socket_test_top.step
1_TEST_PRINTS_print_these_first/single_blade_socket_test_bottom.stl
3_PRINT_PARTS/inlet_vent_louver.stl
5_3D_MODELS_STEP/bearing_support_stationary.step
5_3D_MODELS_STEP/shaft_dimple_drill_guide.step
5_3D_MODELS_STEP/bearing_and_shaft_fit_coupon.step
5_3D_MODELS_STEP/upper_hub_closed_top.step
5_3D_MODELS_STEP/roof_flash_adapter_pitch_0in12.step
5_3D_MODELS_STEP/single_blade_socket_test_bottom.step
5_3D_MODELS_STEP/blade_forming_die_lower.step
5_3D_MODELS_STEP/roof_flash_adapter.step
5_3D_MODELS_STEP/lower_hub_closed_bottom.step
5_3D_MODELS_STEP/slot_clearance_coupon_1p85_1p95_2p05_2p15.step
5_3D_MODELS_STEP/rain_baffle_if_needed.step
5_3D_MODELS_STEP/blade_forming_die_upper.step
3_PRINT_PARTS/thrust_washer_bottom.stl
3_PRINT_PARTS/thrust_washer_top.stl
5_3D_MODELS_STEP/thrust_washer_bottom.step
5_3D_MODELS_STEP/thrust_washer_top.step
