saitokiku/whirlydawg/4_DRAWINGS/images/assembly_exploded_side.png

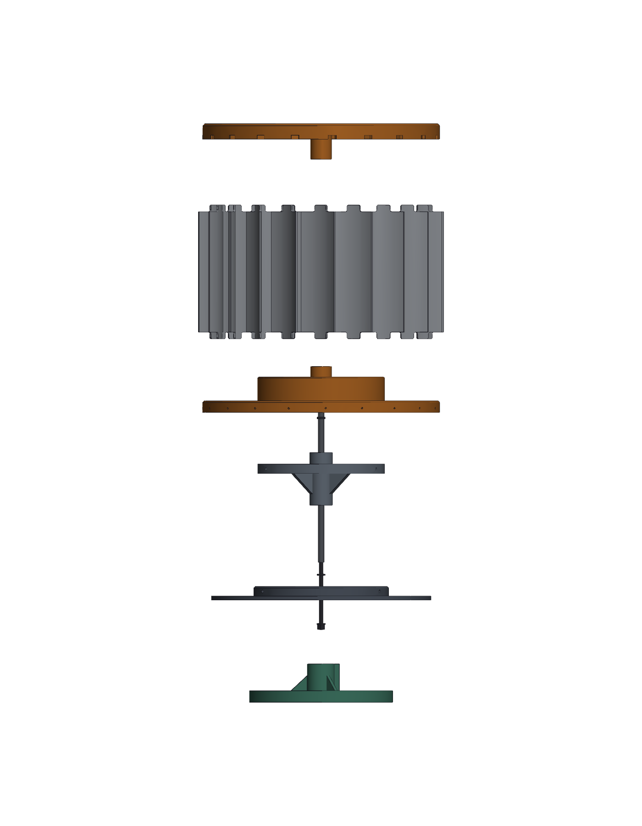
4_DRAWINGS/images/assembly_exploded_side.png
