saitokiku/whirlydawg/4_DRAWINGS/images/assembly_iso_from_below.png

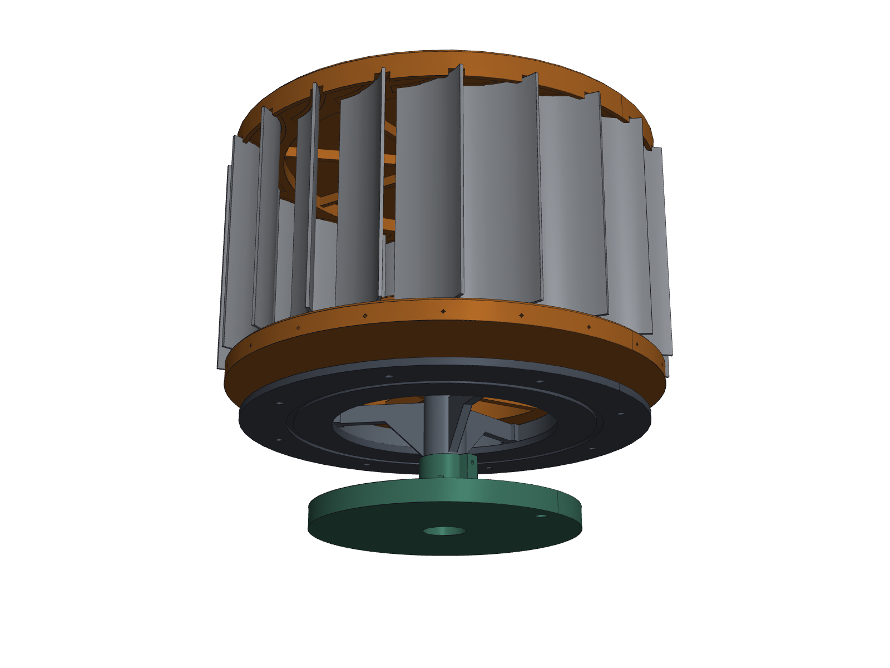
4_DRAWINGS/images/assembly_iso_from_below.png
