saitokiku/whirlydawg/4_DRAWINGS/images/print_bearing_and_shaft_fit_coupon.png

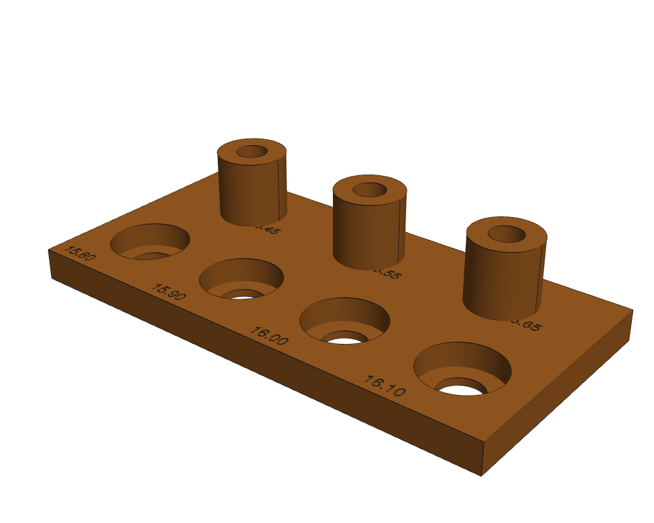
4_DRAWINGS/images/print_bearing_and_shaft_fit_coupon.png
