saitokiku/whirlydawg/4_DRAWINGS/images/print_blade_forming_die_upper.png

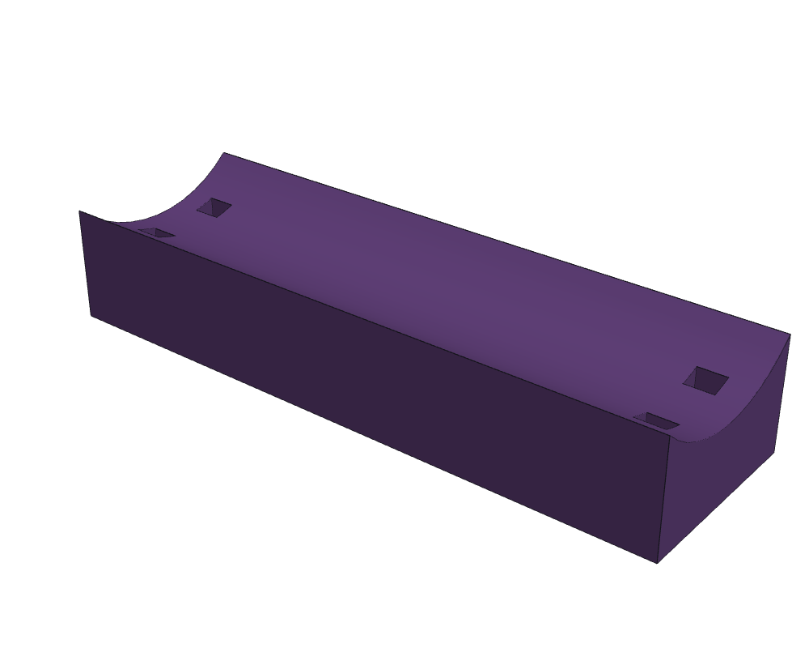
4_DRAWINGS/images/print_blade_forming_die_upper.png
