saitokiku/whirlydawg/4_DRAWINGS/images/print_inlet_vent_louver.png

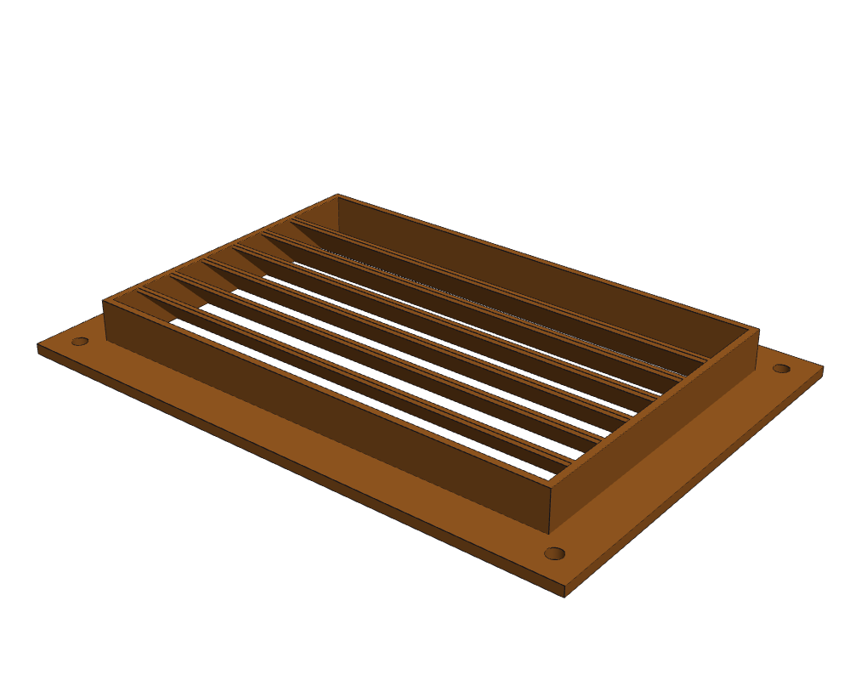
4_DRAWINGS/images/print_inlet_vent_louver.png
