saitokiku/whirlydawg/4_DRAWINGS/images/print_shaft_dimple_drill_guide.png

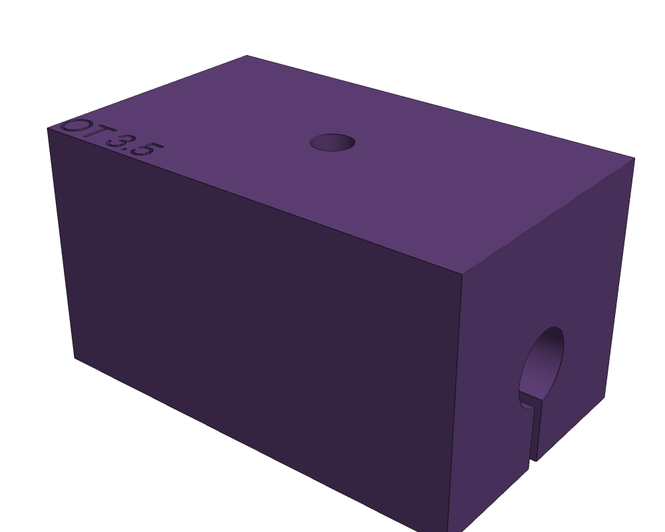
4_DRAWINGS/images/print_shaft_dimple_drill_guide.png
