saitokiku/whirlydawg/4_DRAWINGS/images/print_single_blade_socket_test_bottom.png

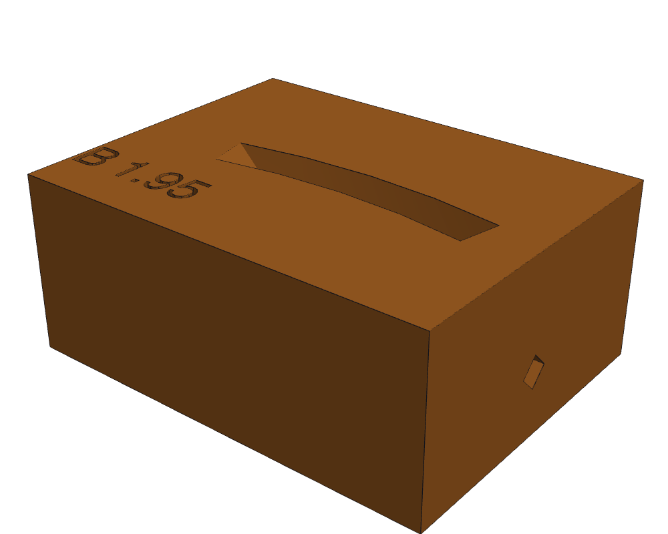
4_DRAWINGS/images/print_single_blade_socket_test_bottom.png
