saitokiku/whirlydawg/4_DRAWINGS/images/print_thrust_washer_bottom.png

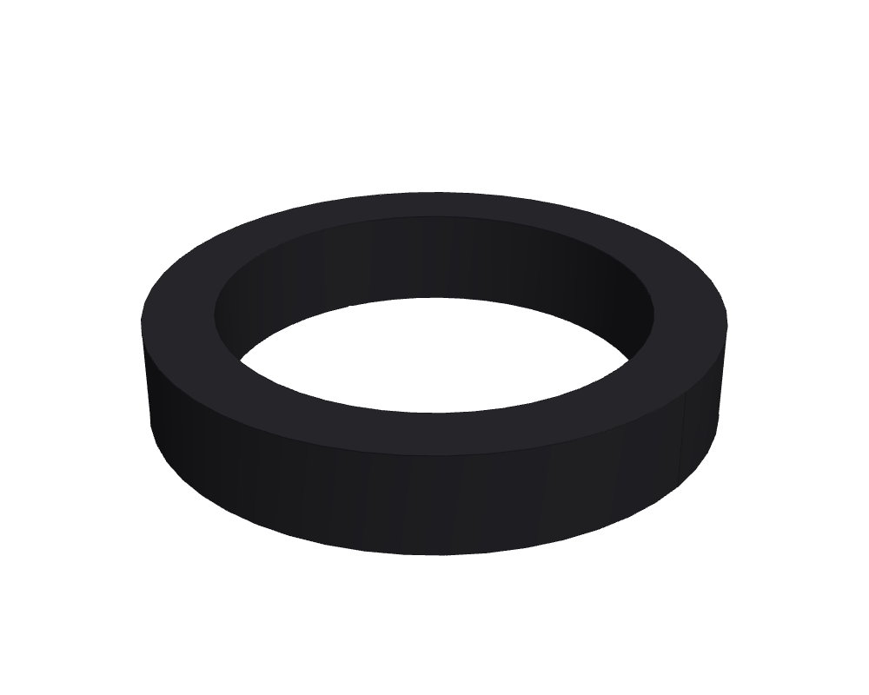
4_DRAWINGS/images/print_thrust_washer_bottom.png
