saitokiku/whirlydawg/whirlybird/reports/mesh_verification_log.txt

STL MESH VERIFICATION LOG (trimesh 5.1.1)
Criteria: watertight, consistent winding, positive volume, exactly 1 body, |mesh-CAD volume| < 1 %,
          extent within 250 x 250 x 256 mm (3 mm bed margin), lowest point on z = 0 (print pose).

PASS  upper_hub_closed_top.stl
      triangles              8482
      watertight             True
      winding_consistent     True
      is_volume              True
      bodies                 1
      euler_number           0
      mesh_volume_mm3        370282.3
      cad_volume_mm3         370451.0
      volume_error_pct       -0.046
      extent_mm              [247.99, 247.98, 37.0]
      min_z                  0.0
      fits_bed               True
      unsupported_down_area_mm2 79.2
      unsupported_max_height_mm 12.0
PASS  lower_hub_closed_bottom.stl
      triangles              8140
      watertight             True
      winding_consistent     True
      is_volume              True
      bodies                 1
      euler_number           -52
      mesh_volume_mm3        477042.8
      cad_volume_mm3         477397.1
      volume_error_pct       -0.074
      extent_mm              [247.94, 247.97, 48.0]
      min_z                  0.0
      fits_bed               True
      unsupported_down_area_mm2 596.8
      unsupported_max_height_mm 44.2
PASS  thrust_washer_top.stl
      triangles              840
      watertight             True
      winding_consistent     True
      is_volume              True
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
      cad_volume_mm3         250510.6
      volume_error_pct       -0.027
      extent_mm              [240.89, 240.88, 74.28]
      min_z                  -0.0
      fits_bed               True
      unsupported_down_area_mm2 2216.1
      unsupported_max_height_mm 67.8

OVERALL: PASS (20 files)
