saitokiku/whirlydawg/4_DRAWINGS/assembly_section.pdf

SHEET 2 - AXIAL HALF-SECTION (plane XZ, true CAD hidden-line projection, 1:2) + HEIGHT STACK

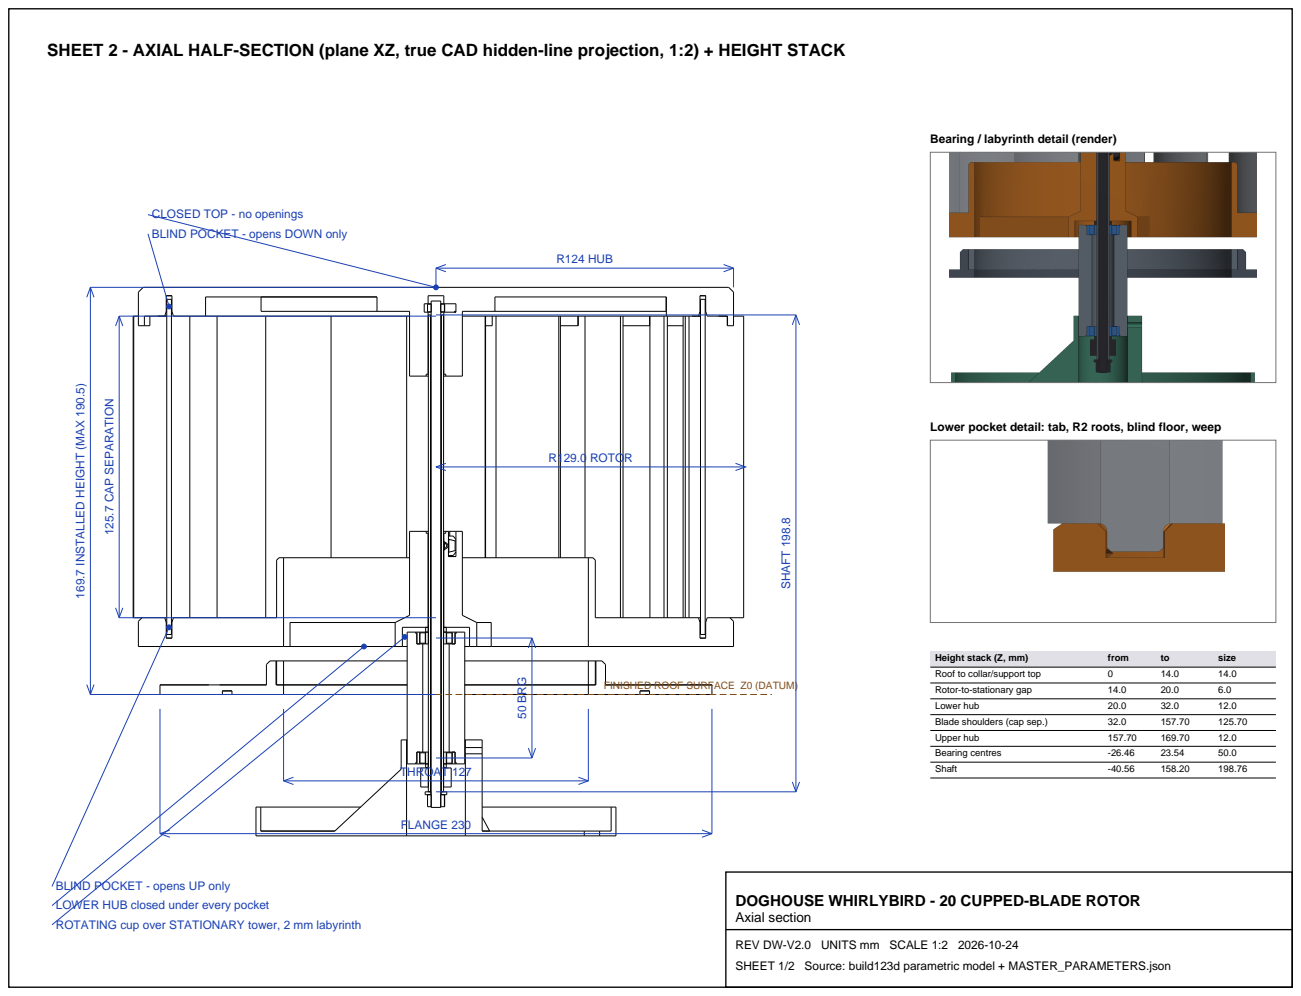
[picture p86: page 1]
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

Bearing / labyrinth detail (render)

CLOSED TOP - no openings
BLIND POCKET - opens DOWN only

169.7 INSTALLED HEIGHT (MAX 190.5)

Lower pocket detail: tab, R2 roots, blind floor, weep

FINISHED ROOF SURFACE Z0 (DATUM)

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

DOGHOUSE WHIRLYBIRD - 20 CUPPED-BLADE ROTOR
Axial section

REV DW-V2.0 UNITS mm SCALE 1:2 2026-10-24
SHEET 1/2 Source: build123d parametric model + MASTER_PARAMETERS.json

## BLIND POCKET SECTIONS - plane along blade-1 chord through the tab centre (true CAD)


UPPER HUB: pocket opens DOWN only; 3.5 mm intact roof; closed toward OD | LOWER HUB: pocket opens UP only; 3.5 mm floor; diamond weep to OD

Tab 1.60 in pocket 1.95: 0.175 mm per side. Tab 14.0 in pocket 14.5: 0.25 mm per end. Tip to floor 1.5 mm.
Mouth: 2 x 45 deg end lead-in clears the R2 tab-root fillets; 0.5 mm side lead-in guides the tab.
Retention: shoulders seat on the hub faces (axial); closed pocket ends/sides (radial + tangential); hubs fixed
to the shaft by set screws in drilled dimples (positive) - so blades cannot escape without removing a hub.

DOGHOUSE WHIRLYBIRD - 20 CUPPED-BLADE ROTOR Blind pocket sections

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
