saitokiku/whirlydawg/(commit log)

2026-10-23 Set up parametric CAD engineer environment (build123d, build123d-mcp, agentcad)
    Adds reproducible bootstrap (scripts/setup.sh + SessionStart hook), MCP
    registration, CAD workflow playbook (CLAUDE.md), spec template, and an
    example parametric enclosure with a check-spec spec.
    Claude-Session: https://claude.ai/code/session_01QLfFvW1WmNBNSoN2yRErBJ
2026-10-23 Add parametric doghouse whirlybird CAD package (DW-V1.1)
    Eight bowed 1.6 mm aluminium vanes retained only by two printed caps with
    blind pockets (upper closed top, lower closed under every pocket), on a
    rotating 1/4 in shaft in a separate stationary two-bearing tower.
    - build123d source driven by MASTER_PARAMETERS.json (derived Z stack,
    cap separation from blade bow, pitch lift, shaft length)
    - 17 automated design gates (interference, rotor/stator clearance,
    blind-pocket walls, assembly sequence, retention, height, bed fit,
    mesh integrity); agentcad inspect/check-spec on every STEP
    - STEP assembly + parts, print-oriented STL, DXF/SVG flat patterns,
    1:1 templates, 12-sheet fabricatio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
    [BOM.csv, bearing_and_shaft_fit_coupon.step, bearing_and_shaft_fit_coupon.stl, bearing_support_stationary.step, bearing_support_stationary.stl, blade_flat_pattern_8x.dxf, blade_flat_pattern_single_TEST.dxf, blade_formed.step]
2026-10-23 Put the ready-to-use CAD files at the front of the repo
    - Root README.md written for non-CAD users; numbered folders in build order:
    1_TEST_PRINTS_print_these_first, 2_BLADES_cut_and_bend, 3_PRINT_PARTS
    (roof adapter per pitch, optional parts), 4_DRAWINGS (+images),
    5_3D_MODELS_STEP; each folder has a plain-language README
    - PRINT_AND_ASSEMBLE.md and BOM.csv moved to the repo root
    - Output locations defined once in whirlybird/cad/layout.py; build,
    study and validation scripts write there (whirlybird/deliverables removed)
    - Technical reports now in whirlybird/reports; STEP round-trip check
    folded into validate_agentcad.py
    - Generic CAD workspace (example part, spec template) moved t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
    [BOM.csv, bearing_and_shaft_fit_coupon.step, bearing_and_shaft_fit_coupon.stl, bearing_support_stationary.step, bearing_support_stationary.stl, blade_flat_pattern_8x.dxf, blade_flat_pattern_single_TEST.dxf, blade_formed.step]
2026-10-24 Redesign rotor as a closed, cupped 20-blade turbine vent (DW-V2.0)
    The 8-blade open layout (58 % ring coverage, 50 mm gaps, vertical bow
    only) would not scoop the wind like a real whirlybird.
    - 20 blades, 44.5 mm wide, cupped across the width (R45, 5.4 mm deep),
    straight vertically, 55 deg from radial: 100.3 % plan coverage with an
    11.5 mm air channel between neighbours; rotor OD 257.9, height 169.7
    - 248 mm caps cover the vane ring; curved blind pockets follow the cup;
    drip-lip notches follow each blade
    - Upper hub now held by an M4 tie rod through the hollow 1/4 in tube
    shaft into a captive nut (tightened from below; no set screw is
    reachable inside a closed ring); lower hub kee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
    [BOM.csv, bearing_and_shaft_fit_coupon.step, bearing_support_stationary.step, blade_flat_pattern_all_blades.dxf, blade_flat_pattern_single_TEST.dxf, blade_formed.step, blade_forming_die_lower.step, blade_forming_die_lower.stl]
